openkeyboard-org/OpenController/hardware/CH572/fab/OpenController-CH572-schematic.pdf

1 | 2 | 3 | 4 | 5 | 6

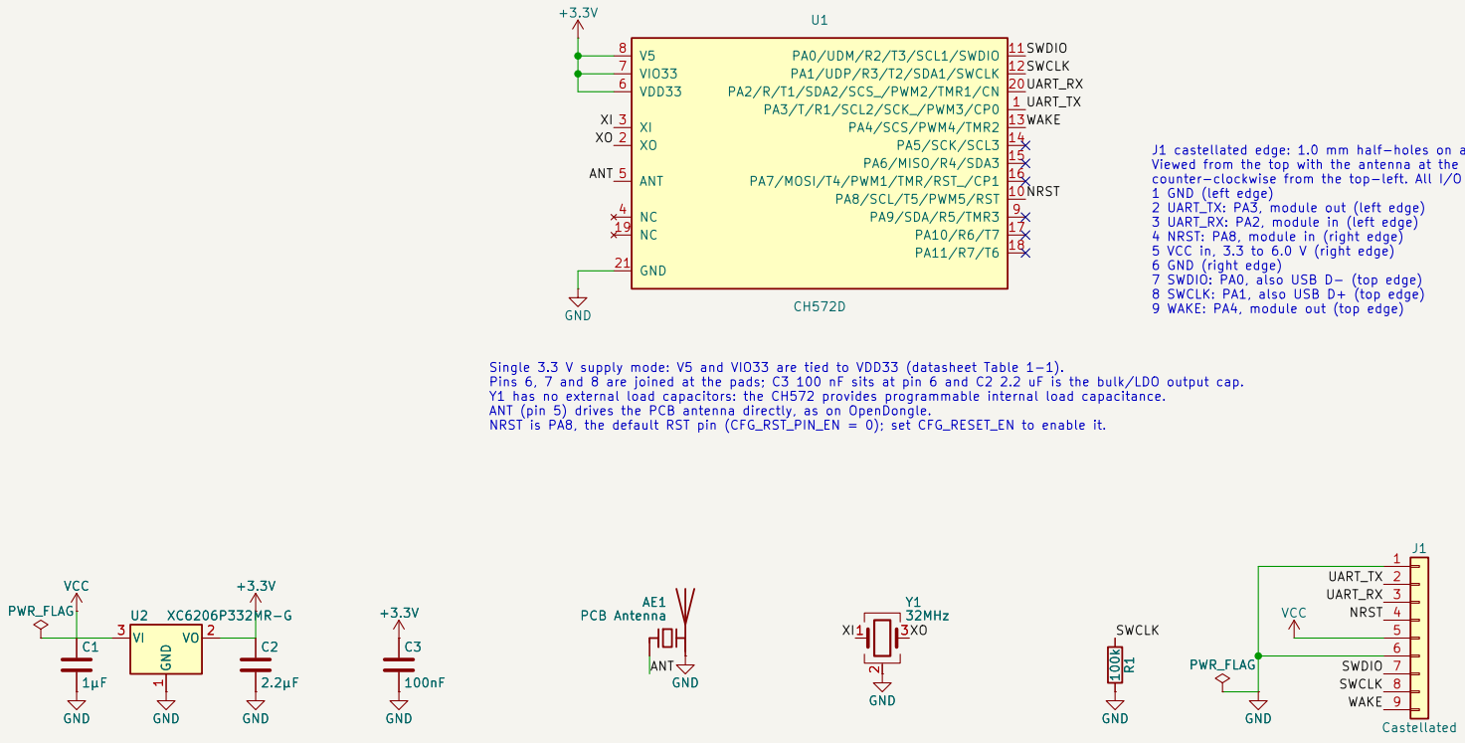
[picture p1: figure]
VCC; AE1 PCB Antenna; GND; Y1 32MHz GND; PWR_FLAG; J1 Castellated PA3/T/R1/SCL2/SCK_/PWM3/CP0; ANT 5; VDD33 6; VIO33 7; PA9/SDA/R5/TMR3; 9 PA8/SCL/T5/PWM5/RST; 10 PA0/UDM/R2/T3/SCL1/SWDIO; 11 PA1/UDP/R3/T2/SDA1/SWCLK; 12 PA4/SCS/PWM4/TMR2; 13 PA5/SCK/SCL3; 14 PA6/MISO/R4/SDA3; 15 PA7/MOSI/T4/PWM1/TMR/RST_/CP1; PA2/R/T1/SDA2/SCS_/PWM2/TMR1/CN; 20 GND 21; GND GND; GND +3.3V C2; +3.3V PWR_FLAG; ANT; WAKE UART_TX; ANT XO; UART_RX; SWDIO; WAKE; SWCLK; Y1 32MHz 1; 3 GND; 100nF GND +3.3V C2; 2.2µF +3.3V GND; GND U2; XC6206P332MR-G GND; VI 3 PWR_FLAG; 1µF GND; GND R1 100k

1 | 2 | 3 | 4 | 5 | 6

AB

C

D

AB

C

### D Date: 2026-10-25

Size: A4 | Rev: 0.1
KiCad E.D.A. 10.0.6 | Id: 1/1

## Title: OpenController CH572

### File: OpenController-CH572.kicad_sch

### Sheet: /

## Copyright 2026 Eric Molitor (EMulator)

### github.com/openkeyboard-org/OpenController

### CERN-OHL-W CERN Open Hardware Licence Version 2 - Weakly Reciprocal C3

NRST | SWCLK UART_RX NRST XI | SWCLK | UART_TX R1 holds PA1 low when J1 pad 8 is left open. PA1 is the ROM boot strap

(PA1 high + PA0 low at power-on enters USB/UART ISP), USB D+ and SWCLK.

J1 castellated edge: 1.0 mm half-holes on a 0.1 in grid, three per edge. Viewed from the top with the antenna at the bottom, pads count counter-clockwise from the top-left. All I/O is 3.3 V. 1 GND (left edge) 2 UART_TX: PA3, module out (left edge) 3 UART_RX: PA2, module in (left edge) 4 NRST: PA8, module in (right edge) 5 VCC in, 3.3 to 6.0 V (right edge) 6 GND (right edge) 7 SWDIO: PA0, also USB D- (top edge) 8 SWCLK: PA1, also USB D+ (top edge) 9 WAKE: PA4, module out (top edge)

Single 3.3 V supply mode: V5 and VIO33 are tied to VDD33 (datasheet Table 1-1). Pins 6, 7 and 8 are joined at the pads; C3 100 nF sits at pin 6 and C2 2.2 uF is the bulk/LDO output cap. Y1 has no external load capacitors: the CH572 provides programmable internal load capacitance. ANT (pin 5) drives the PCB antenna directly, as on OpenDongle. NRST is PA8, the default RST pin (CFG_RST_PIN_EN = 0); set CFG_RESET_EN to enable it. AE1 PCB Antenna | GND
