openkeyboard-org/OpenController/hardware/CH572/OpenController-CH572.kicad_pcb

## KiCad design hardware/CH572/OpenController-CH572.kicad_pcb (2026-10-25)

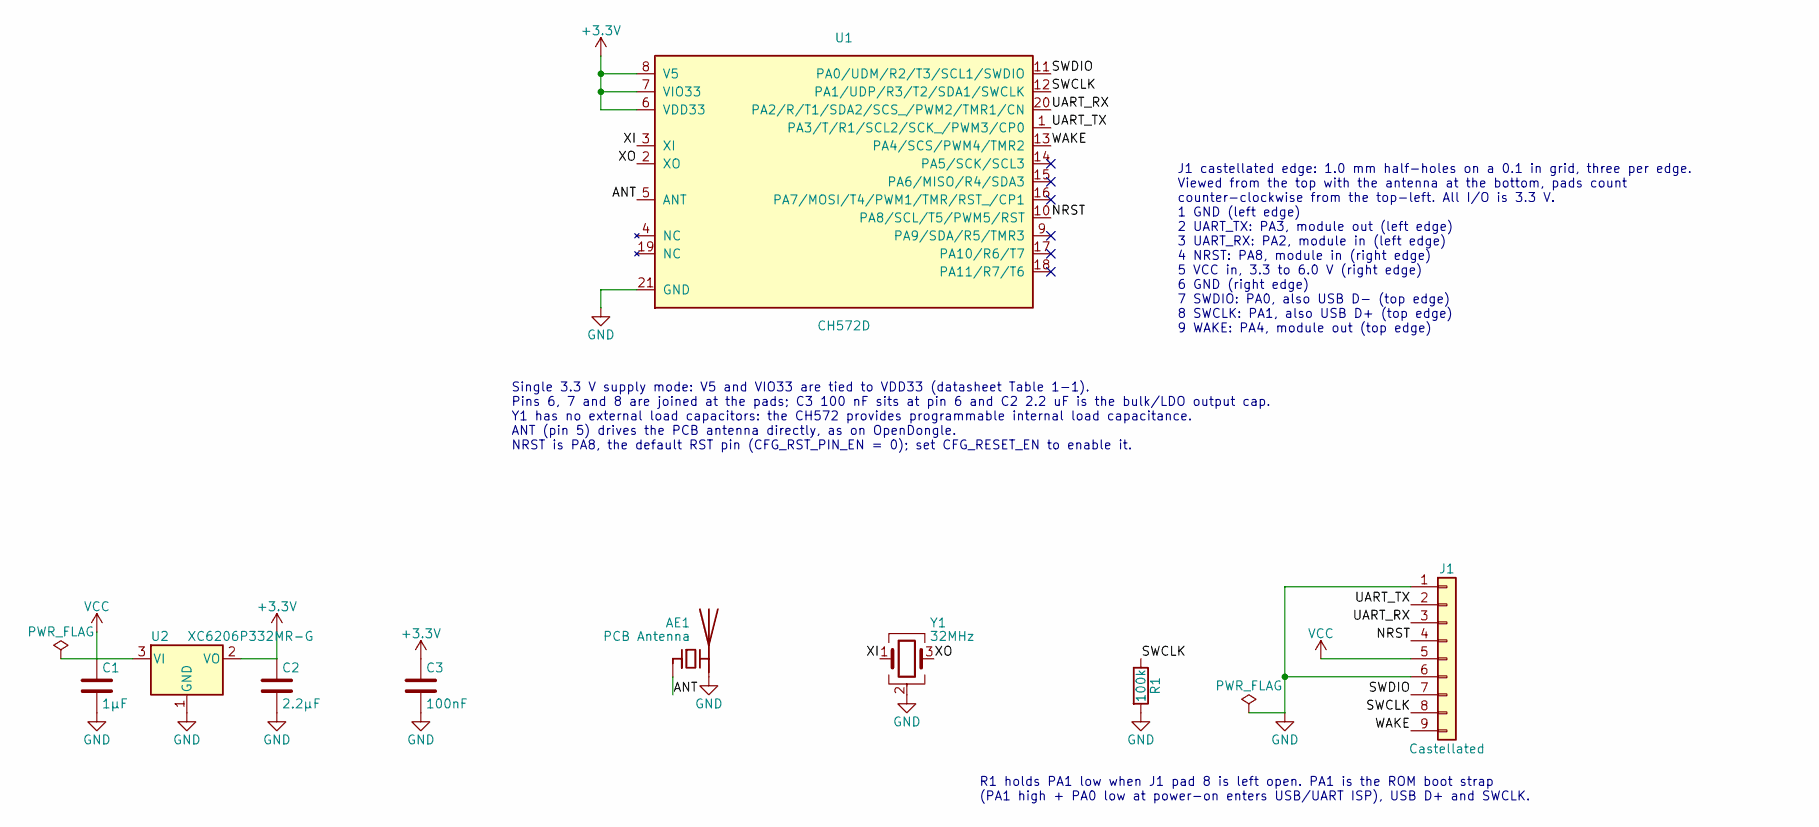
[picture p2: schematic OpenController-CH572.kicad_sch, OpenController CH572]

Parts:
AE1: PCB Antenna; ANT-F-2-2.4G-0.8MM-FR4-WCH
C1: 1µF; C_0603_1608Metric; LCSC C15849
C2: 2.2µF; C_0603_1608Metric; LCSC C23630
C3: 100nF; C_0603_1608Metric; LCSC C14663
J1: Castellated; Castellated_CH572_10.16x20.5mm
R1: 100k; R_0603_1608Metric; LCSC C25803
U1: CH572D; CH572D_QFN-20_3x3mm_P0.4mm_EP1.8mm_ThermalVias; LCSC C46597863
U2: XC6206P332MR-G; SOT-23-3; LCSC C5446
Y1: 32MHz; Crystal_SMD_2016-4Pin_2.0x1.6mm; LCSC C37635332

Connections:
+3.3V: C2.1, C3.1, U1.6 (VDD33), U1.7 (VIO33), U1.8 (V5), U2.2 (VO)
/ANT: AE1.1 (FEED), U1.5 (ANT)
/NRST: J1.4, U1.10 (PA8/SCL/T5/PWM5/RST)
/SWCLK: J1.8, R1.1, U1.12 (PA1/UDP/R3/T2/SDA1/SWCLK)
/SWDIO: J1.7, U1.11 (PA0/UDM/R2/T3/SCL1/SWDIO)
/UART_RX: J1.3, U1.20 (PA2/R/T1/SDA2/SCS_/PWM2/TMR1/CN)
/UART_TX: J1.2, U1.1 (PA3/T/R1/SCL2/SCK_/PWM3/CP0)
/WAKE: J1.9, U1.13 (PA4/SCS/PWM4/TMR2)
/XI: U1.3 (XI), Y1.1
/XO: U1.2 (XO), Y1.3
GND: AE1.2 (PCB_Trace), C1.2, C2.2, C3.2, J1.1, J1.6, R1.2, U1.21 (GND), U2.1 (GND), Y1.2 (G), Y1.4 (G)
VCC: C1.1, J1.5, U2.3 (VI)

Notes on the sheet:
Single 3.3 V supply mode: V5 and VIO33 are tied to VDD33 (datasheet Table 1-1). Pins 6, 7 and 8 are joined at the pads; C3 100 nF sits at pin 6 and C2 2.2 uF is the bulk/LDO output cap. Y1 has no external load capacitors: the CH572 provides programmable internal load capacitance. ANT (pin 5) drives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
R1 holds PA1 low when J1 pad 8 is left open. PA1 is the ROM boot strap (PA1 high + PA0 low at power-on enters USB/UART ISP), USB D+ and SWCLK.
J1 castellated edge: 1.0 mm half-holes on a 0.1 in grid, three per edge. Viewed from the top with the antenna at the bottom, pads count counter-clockwise from the top-left. All I/O is 3.3 V. 1 GND (left edge) 2 UART_TX: PA3, module out (left edge) 3 UART_RX: PA2, module in (left edge) 4 NRST: PA8, 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

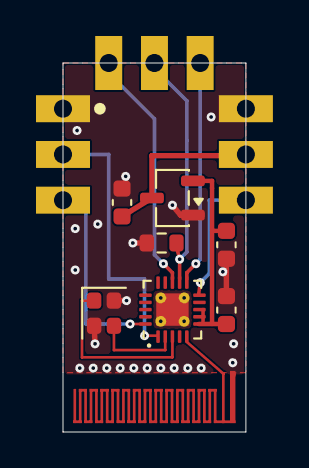
[picture p3: board OpenController-CH572.kicad_pcb from above]

Board: 2 copper layers, 10.2 x 20.5 mm, 9 parts (0 on the bottom side), 12 nets.
