openkeyboard-org/OpenController/firmware/src/rf_task.c

/* Copyright 2026 Eric Molitor (EMulator)
 * SPDX-License-Identifier: Apache-2.0
 */
#include "CONFIG.h"
#include "HAL.h"
#include "ISP592.h"
#include "keyboard_uart.h"
#include "rf_task.h"

#define RF_EVT_START              0x0001
#define RF_EVT_RX_RESTART         0x0002
#define RF_EVT_PAIR_BCAST         0x0004
#define RF_EVT_PAIR_TIMEOUT       0x0008
#define RF_EVT_ENTER_CONNECTED    0x0010
#define RF_EVT_RESPOND            0x0020   /* connected poll-response TX (main loop) */
#define RF_EVT_NOTIFY_LED         0x0040
#define RF_EVT_SAVE_BOND          0x0100   /* deferred DataFlash write, not from RF ISR */
#define RF_EVT_PAIR_RX_OFF        0x0200   /* close the post-beacon listen window
                                            * (bonded-reconnect duty cycle, MR4) */

/* Stock-interop H1/H2 discriminator: skip the first N connected-poll responses
 * (keep listening/tracking, no uplink TX). If the keyboard then catches several
 * MORE stock polls before teardown, the running RX/track is fine and it is our
 * RESPONSE that trips the stock dongle's fast supervision teardown (H1). Needs
 * RF_DIAG_COUNTERS (uses the .diag_safe ll_resp_suppressed counter). */
#ifndef STOCK_SUPPRESS_RESPONSES
#define STOCK_SUPPRESS_RESPONSES 0
#endif
/* H1/H2 probe: after the first caught poll, stay parked on that channel (never
 * advance the time-based hop). If the dongle is still polling, the parked
 * keyboard keeps catching it (=> our hop tracking is the fault); if not, the
 * dongle stopped (=> it tore the link down). */
#ifndef STOCK_PARK_AFTER_CATCH
#define STOCK_PARK_AFTER_CATCH 0
#endif
/* Bench probe: transmit the poll response directly in the TMR0 turnaround ISR
 * instead of deferring to the main-loop RF_EVT_RESPOND event. The direct ISR
 * path did not fix stock reconnect; the validated default is main-loop TX after
 * the 6000-count turnaround below. */
#ifndef STOCK_ISR_FAST_RESPONSE
#define STOCK_ISR_FAST_RESPONSE 0
#endif
/* Fast-response fix (matches stock firmwareB.bin 0x20000f06): skip the redundant
 * RF_SetChannel before the response TX -- the radio is already on the poll channel;
 * re-setting it costs a ~150us PLL relock that misses the stock dongle's RX window. */
#ifndef STOCK_RESP_NO_SETCH
#define STOCK_RESP_NO_SETCH 1
#endif
/* Acquisition coarse-align probe: on the FIRST connected poll
 * caught while parked (provisional), SNAP hop_anchor to that poll's measured
 * start instead of a ±1 servo nudge -- the ±1 servo can't lock a large initial
 * phase error from a single parked catch, so the keyboard misses subsequent
 * polls off the real stock dongle's grid. Keeps the ±1 servo for later polls. */
#ifndef STOCK_ACQ_SNAP
#define STOCK_ACQ_SNAP 0
#endif
/* Gap-free acquisition probe: while provisional, keep the radio continuously
 * parked on the seed/catch channel instead of RF_Shut+RF_Rx re-arming every
 * interval. Pair with STOCK_PARK_AFTER_CATCH=1 to stay parked after the first
 * catch and prove whether periodic re-arm gaps were hiding later stock polls. */
#ifndef STOCK_CONTINUOUS_PARK_ACQ
#define STOCK_CONTINUOUS_PARK_ACQ 0
#endif
/* Bench probe: some stock-dongle reconnect state reports one interval in the
 * LEN-15 payload while its measured connected-poll cadence is another. Nonzero
 * overrides the parsed connected interval after sanity-checking the packet. */
#ifndef STOCK_FORCE_CONN_INTERVAL
#define STOCK_FORCE_CONN_INTERVAL 0
#endif
/* Stock-interop fix: the pair-ACK type tag is the previous connected-hop seed.
 * The dongle's first connected poll one interval later is therefore seed+1.
 * Keep this configurable only for bench regressions against old hypotheses. */
#ifndef STOCK_CONNECT_IDX_BIAS
#define STOCK_CONNECT_IDX_BIAS 1
#endif
#define RF_EVT_DISCONNECT         0x0080
#define RF_EVT_REST_IDLE          0x0400   /* resting policy: no host report for KBD_REST_IDLE_TICKS */
#define RF_EVT_REST_PROBE         0x0800   /* resting policy: probe cadence */
#define RF_EVT_REST_PROBE_TIMEOUT 0x1000   /* resting policy: probe not caught / not polled in time */
#define RF_EVT_REST_STAGE2        0x2000   /* resting policy: stop probing */
#define RF_EVT_DISCARD_HID        0x4000   /* the host left 2.4 GHz: drop what it queued (0x8000 is TMOS's) */

/* A SELECT_USB that a SELECT_2G4 follows within this long is a forced
 * reconnect, not a switch to USB: QMK sends the pair back to back to get a
 * fresh CONNECTED, and the reports queued for 2.4 GHz are still wanted. TMOS
 * ticks of 0.625 ms. */
#ifndef KBD_RESELECT_KEEP_TICKS
#define KBD_RESELECT_KEEP_TICKS   800u     /* 500 ms */
#endif

#define RF_DEFAULT_ACCESS_ADDR    0x71764126u
#define RF_CRC_INIT               0x555555u
#define RF_LLE_MODE               (LLE_MODE_BASIC | LLE_WHITENING_ON | LLE_MODE_PHY_2M)
#define RF_RX_MAX_LEN             70

#define RF_PAIR_INTERVAL          28u
#define RF_PAIR_TIMEOUT_VALUE     600u
#define RF_PAIR_BCAST_TICKS       32u      /* 20 ms at 625 us/tick */
#define RF_PAIR_WINDOW_TICKS      8480u    /* stock pair window is about 5.3 s */
#define RF_PAIR_DWELL_BCASTS      12u

/* Bonded-reconnect radio duty cycle (power ladder MR4). A bonded keyboard
 * whose dongle is absent searches FOREVER (boot-with-bond and A6 30 arm no
 * pair timeout), and until this rung it held the receiver open for the whole
 * 20 ms beacon period -- the single largest measured burner (7.75 mA vs
 * 0.68 mA idle). With the duty cycle, RX stays open only for a short window
 * after each beacon; the dongle's reconnect reply lands right after the
 * beacon it heard, so the window covers it. Behavior change: reconnect
 * latency may grow -- bench-measured before merge, window sized from the
 * distribution. EXPLICIT user pairing (A6 51/63) keeps continuous RX: it is
 * user-attended, latency-sensitive, and bounded by the 5.3 s window.
 *
 * WINDOW LOWER BOUND (bench 2026-09-04, OpenDongle + this module). The
 * OpenDongle CH570 sends its LEN-15 reconnect reply 2.5 ms after the beacon
 * it heard (RF_CH570_PAIR_ACK_PRE_TX_TMOS = 4 x 625 us, the Bridge75 stock
 * keyboard's optimum), ~214 us more to its TX-finish callback (both
 * software-measured on the dongle: accept -> StartTx 2538..2551 us). This
 * receiver arms ~0.2 ms after the beacon (estimate), so a 4-tick (2.5 ms)
 * window closed at beacon + ~2.7 ms -- consistent with that reply completing
 * on the closing edge, not sniffed -- and MISSED IT EVERY TIME from the
 * dongle's terminal camps
 * (its first reconnect after boot, and its channel-8 camp after an EV10
 * give-up): 0 valid RX in 500 beacons, 3/3 dongle cold boots, no recovery
 * short of a fresh pair (whose continuous RX tolerates the late reply). The
 * dongle's EV10 reacquire path replies ~0.3 ms after the beacon, which is
 * why a dongle that had connected once still reconnected -- the window had
 * been sized against that path. 6 ticks = 3.75 ms leaves ~1 ms of
 * packet-completion margin over the camp reply (6/6 cold at 6). Cost:
 * 12.5% -> 18.75% RX duty in bonded search. KNOWN on bench: 4 ticks fails
 * (0/8 cold), 6 ticks works (6/6 cold); 5 and 3 were NOT tested. So <= 4 is
 * proven-bad and < 6 is unproven -- re-measure against a cold-booted dongle
 * before lowering below the 6-tick default. */
#ifndef KBD_PAIR_DUTY_CYCLE
#define KBD_PAIR_DUTY_CYCLE 1
#endif
#ifndef KBD_PAIR_RX_WINDOW_TICKS
#define KBD_PAIR_RX_WINDOW_TICKS 6u        /* 3.75 ms of 20 ms = 18.75% RX duty;
                                            * 4 fails on bench, <6 unproven --
                                            * see the window lower bound above */
#endif

/* Which flavor of PAIRING we are in. Deliberately an EXPLICIT tag set at the
 * three entry points, never inferred from rf_access_addr: fresh pairing
 * flips rf_access_addr to the session AA on its FIRST handshake packet, so
 * the AA cannot distinguish the flavors mid-handshake (adversarial-review
 * finding on the plan). */
#define PAIR_FLAVOR_FRESH   0u             /* A6 51/63: continuous RX */
#define PAIR_FLAVOR_BONDED  1u             /* boot-with-bond / A6 30: duty-cycled */

/* Resting policy (RESTING_POLICY.md). After KBD_REST_IDLE_TICKS without a host
 * report on a connected link, drop the session SILENTLY (no frame to the dongle,
 * which lapses by its own supervision; nothing to the keyboard MCU, which keeps
 * seeing a connected link) and probe the dongle every KBD_REST_PROBE_TICKS with a
 * bonded reconnect that answers KBD_REST_PROBE_ANSWERS polls and goes quiet
 * again. The dongle's detector locks onto that cadence and windows/halts around
 * it. After KBD_REST_STAGE2_TICKS stop probing until a key. A host report while
 * resting probes at once and keeps the session. Ticks are TMOS units (625 us).
 * T_probe / T_deep are production parity (1.010 s / 30 min), owner-decided
 * 2026-09-11. T_idle is 3 s by default, owner-decided 2026-09-13 after the hold
 * sweep (firmware/bench/2026-09-13-rest-hold-sweep: 24 mC per key from rest vs
 * 39 at 5 s, delivery and latency unchanged); the Makefile's KBD_REST_IDLE_MS
 * knob passes it as KBD_REST_IDLE_TICKS (production parity: 5000 ms). */
#ifndef KBD_REST
#define KBD_REST 1
#endif
#ifndef KBD_REST_IDLE_TICKS
#define KBD_REST_IDLE_TICKS          4800u    /* 3 s; the Makefile passes KBD_REST_IDLE_MS x 8/5 */
#endif
#ifndef KBD_REST_PROBE_TICKS
#define KBD_REST_PROBE_TICKS         1616u    /* 1010 ms: inside the dongle's 900-1100 ms cadence window */
#endif
#ifndef KBD_REST_PROBE_ANSWERS
#define KBD_REST_PROBE_ANSWERS       2u       /* polls answered per probe: the dongle's detector needs >= 1;
                                               * 2 keeps a scheduled drop valid even if one answer is lost.
                                               * The average current is answer-count-insensitive (bench:
                                               * the ~50-120 ms burst is the dongle's post-probe supervision
                                               * hold, not our TX) -- see RESTING_POLICY.md. */
#endif
#if KBD_REST && (KBD_REST_PROBE_ANSWERS < 1)
#error "KBD_REST_PROBE_ANSWERS must be >= 1: the dongle's scheduled-drop detector needs at least one answered poll (rf_win_link_rx >= RF_WIN_MIN_LINK_RX), or every probe drop is classified unscheduled and the detector unlocks."
#endif
#ifndef KBD_REST_PROBE_TIMEOUT_TICKS
#define KBD_REST_PROBE_TIMEOUT_TICKS 640u     /* 400 ms: two of the dongle's 200 ms window periods */
#endif
#ifndef KBD_REST_STAGE2_TICKS
#define KBD_REST_STAGE2_TICKS        2880000u /* 30 min: production's second stage */
#endif
#ifndef KBD_REST_IDLE_RETRY_TICKS
#define KBD_REST_IDLE_RETRY_TICKS    160u     /* 100 ms: a report still draining when the idle timer fires */
#endif
#define RF_CONNECTED_TIMEOUT_TICKS 5000u   /* ~3.1 s; FIXED connection supervision --
                                            * the dongle's advertised timeout field is
                                            * intentionally not honored (stock scales it
                                            * by an unproven factor; this is validated) */

#define RF_BOND_EEPROM_OFF        0x4000u  /* DataFlash 0x74000: stock keyboard 2.4G bond page */
#define RF_BOND_EEPROM_ERASE_LEN  256u
#define RF_BOND_MAGIC             0x3244424bu  /* "KBD2" little-endian */
#define RF_BOND_VERSION           1u

#define R32_RTC_CNT_32K_ADDR      0x40001038u
#define SYSTICK_CNT_ADDR          0xE000F008u
#define RTC32K_WRAP               0xa8c00000u   /* RTC32K counter modulus */
#define RF_POLL_BACKDATE_BASE     12u           /* RX latency: a caught poll's start is
                                                 * now-(BASE+(len>>3)) -- LEN 1/3 -> 12,
                                                 * LEN 10/15 -> 13 (the inline servo) */
#define RF_HOP_ANCHOR_BACKDATE    (RF_POLL_BACKDATE_BASE + 1u)  /* seed/re-seed (LEN>=8) */
#define RF_HOP_DESYNC_INTERVALS   64u           /* gap (in intervals) treated as desync */

#ifndef KBD_FACTORY_MAC
#define KBD_FACTORY_MAC 0
#endif

#ifndef KBD_MAC_0
#define KBD_MAC_0 0xbd
#define KBD_MAC_1 0xc3
#define KBD_MAC_2 0xab
#define KBD_MAC_3 0x10
#define KBD_MAC_4 0x53
#define KBD_MAC_5 0x5c
#endif

#ifndef STOCK_SEED_BOND
#define STOCK_SEED_BOND 0
#endif
#ifndef STOCK_SEED_SESSION_AA
#define STOCK_SEED_SESSION_AA 0x00000000u
#endif
#ifndef STOCK_SEED_TYPE_TAG
#define STOCK_SEED_TYPE_TAG 0u
#endif
#ifndef STOCK_SEED_DONGLE_MAC_0
#define STOCK_SEED_DONGLE_MAC_0 0x00
#define STOCK_SEED_DONGLE_MAC_1 0x00
#define STOCK_SEED_DONGLE_MAC_2 0x00
#define STOCK_SEED_DONGLE_MAC_3 0x00
#define STOCK_SEED_DONGLE_MAC_4 0x00
#define STOCK_SEED_DONGLE_MAC_5 0x00
#endif

#if KBD_FACTORY_MAC
/* GetMACAddress writes six bytes through the ROM flash API and requires a
 * four-byte-aligned destination (ISP592.h).  Keep validity separate: an API
 * failure, all-zero value, or erased all-0xFF value must never become a
 * shared RF pairing identity. */
static uint8_t keyboard_mac[6] __attribute__((aligned(4)));
static uint8_t keyboard_mac_valid;
#else
static const uint8_t keyboard_mac[6] = {
    KBD_MAC_0, KBD_MAC_1, KBD_MAC_2, KBD_MAC_3, KBD_MAC_4, KBD_MAC_5
};
#define keyboard_mac_valid 1u
#endif
#define NUM_PAIR_CHANNELS  3u
#define NUM_DATA_CHANNELS  5u
#define RF_HOP_MAX_STEP    NUM_DATA_CHANNELS  /* clamp a stale advance to one full hop cycle */
static const uint8_t pair_channels[NUM_PAIR_CHANNELS] = {8, 17, 26};
static const uint8_t data_channels[NUM_DATA_CHANNELS] = {4, 13, 20, 28, 33};

static uint8_t rf_taskID;
static uint8_t rf_state;
/* PAIR_FLAVOR_* tag; meaningful only while rf_state == RF_STATE_PAIRING. */
static uint8_t pair_flavor;
/* Listen-window epoch: RX_RESTART in PAIRING re-arms the receiver only while
 * this is set. Cleared by the RX_OFF handler so a STALE RX_RESTART (posted by
 * a late TX-finish or RX-error callback before the window closed) cannot
 * silently reopen RX for the rest of the beacon period (adversarial-review
 * finding on the plan). Set by every pairing entry and every beacon. */
static volatile uint8_t pair_rx_open;
/* One close-timer per beacon epoch: set when the first RX_RESTART of the
 * epoch arms the receiver AND starts the RX_OFF timer, so RX-error restarts
 * within the window do not keep extending it. Cleared per beacon and by the
 * RX_OFF handler. */
static volatile uint8_t pair_rx_off_armed;
static int8_t rf_rssi;
static uint32_t rf_access_addr;
static uint8_t rf_channel;
static uint16_t rf_conn_interval;

static uint8_t has_bond;
static uint8_t stored_dongle_mac[6];
static uint32_t stored_session_aa;
static uint8_t stored_type_tag;

typedef struct {
    uint32_t magic;
    uint8_t  version;
    uint8_t  type_tag;
    uint16_t reserved0;
    uint32_t session_aa;
    uint8_t  dongle_mac[6];
    uint16_t reserved1;
    uint32_t checksum;
} rf_bond_record_t;

static uint8_t pair_bcast_count;
static uint8_t pair_payload[10];

static uint8_t pending_type_tag;
static uint16_t pending_interval;
static uint32_t pending_session_aa;

/* Report FIFO (step 3). Replaces the single `hid_report` slot: a report queued
 * while the link is down MUST survive until the dongle actually acknowledges it,
 * otherwise the key-up 60 ms later overwrites the key-down and the first key
 * from rest is lost (measured 35-40 % loss). Stock's module keeps a 20-slot
 * ack-retired ring for exactly this reason.
 * Single-producer / single-consumer: `hid_fifo_tail` is written ONLY by the main
 * loop (RF_QueueHIDReport, from the UART frame callback); `hid_fifo_head` ONLY by
 * the RX ISR when the dongle advances its control bit (the acknowledgement).
 * Free-running indices, power-of-two capacity; occupancy = (uint8_t)(tail-head). */
#define HID_FIFO_SLOTS 16u
#if (HID_FIFO_SLOTS & (HID_FIFO_SLOTS - 1u)) != 0u
#error "HID_FIFO_SLOTS must be a power of two: the head/tail indices are free-running and masked"
#endif
static uint8_t hid_fifo[HID_FIFO_SLOTS][8];
static volatile uint8_t hid_fifo_head;      /* ISR-owned: retire on ack */
static volatile uint8_t hid_fifo_tail;      /* main-loop-owned: enqueue */
static volatile uint8_t hid_head_sent;      /* head is in flight; an ack may retire it */
static uint8_t hid_last_queued[8];          /* newest queued state (adjacent-duplicate dedup) */
static uint8_t hid_last_queued_valid;

/* True while the newest host report holds any key or modifier. */
static inline uint8_t hid_key_held(void)
{
    return (uint8_t)(hid_last_queued_valid
                     && (hid_last_queued[0]|hid_last_queued[1]|hid_last_queued[2]|hid_last_queued[3]
                        |hid_last_queued[4]|hid_last_queued[5]|hid_last_queued[6]|hid_last_queued[7]));
}

/* Drop every queued report. IDLE only: the radio is shut then, so the RX ISR
 * that retires the head can't run. */
static void rf_discard_hid_queue(void)
{
    hid_fifo_head = hid_fifo_tail;
    hid_head_sent = 0;
}
static uint8_t tx_payload[10];
static uint8_t tx_ctrl;
static uint8_t prev_data_idx;     /* current connected data-channel index */
static volatile uint8_t pending_led;
static volatile uint8_t last_led_sent;
/* hid_resend (blind attempt counter) removed: the head is re-sent every poll
 * until acknowledged, and retired ONLY by the ack (see hid_fifo_head). */
static volatile uint8_t hid_tx_down_inflight; /* a non-zero HID frame started TX; awaiting TX_FINISH to count it as on-air */

/* Connected-mode time-based hop (mirrors stock firmwareB.bin 0x20000E06/0x20000D60).
 * hop_anchor (like tx_ctrl) is written by BOTH the RX ISR (hop_servo / ctrl-ARQ) and the
 * main loop, yet is deliberately NOT volatile: every main-loop access is wrapped in
 * rf_irq_save/rf_irq_restore (IRQs off) so the ISR can't interleave a partial update, and
 * the "memory" clobber bars stale caching across the section. */
static uint32_t hop_anchor;             /* RTC32K phase anchor (gp+0x78 equivalent) */
static volatile uint16_t since_rx;      /* hop slots since the last caught poll */
static uint32_t pending_anchor;         /* anchor latched at the 2nd 15-byte (rx-13) */

/* Response-slot latch (Codex): the response must TX on the channel the poll was
 * received on, not the (possibly already-advanced) hop channel, and the hop must
 * not retune the radio while a response is pending. */
static volatile uint8_t  response_channel;
static volatile uint8_t  response_ctrl;
static volatile uint8_t  response_pending;
static volatile uint32_t response_armed_rtc;   /* RTC32K when response_pending was set */
/* Set at (re)connect: PARK on the seed channel (re-arm RX every interval, don't
 * advance the index) until the first poll is caught -- a swept keyboard never
 * meets the swept dongle, so wait for the dongle to sweep onto our parked
 * channel, then the first caught poll snaps the phase and we resume tracking.
 * This is what makes a bonded reconnect lock in (its 15-byte seed mis-aligns
 * the sweep, and with zero catches there is nothing to snap to). */
static volatile uint8_t  provisional;
static volatile uint8_t  bond_save_pending;

/* Set by the RX ISR when a connected-mode poll arrives; the main loop
 * (RF_ConnectedTick) re-arms the supervision timer from it. tmos_start_task /
 * tmos_stop_task mutate the TMOS timer linked list, and our BB status callback is
 * a hardware fast-vectored (VTF) interrupt the lib's TMOS critical section does
 * not mask -- so mutating the list from the ISR would race the main-loop walk
 * (tmos_proces_system_time). We keep list mutation in main-loop context only as a
 * correctness/ISR-safety measure. (NB: the v1.4.2 "TMOS HardFault" this originally
 * chased turned out to be a debugger-perturbation artifact, not an operational
 * fault, but deferring ISR list mutation is good practice regardless and is
 * retained.) */
static volatile uint8_t  supervision_kick;
#if KBD_REST
static uint8_t rest_stage;                    /* 0 not resting, 1 probing, 2 no probes until a key */
static uint8_t rest_probe;                    /* a probe's search/connection is in flight */
static uint8_t rest_probe_wake;               /* a host report arrived: this probe becomes the session */
static uint8_t rest_answers;                  /* polls answered in the current probe */
static volatile uint8_t rest_quiet_pending;   /* end the probe once its reply TX has drained */
#endif


/* TMR0 one-shot post-poll turnaround. Stock firmwareB.bin FUN_ram_00005abe arms
 * 300 TMR0 counts (~5 us @ 60 MHz), but this main-loop deferred TX path needs a
 * longer empirically validated delay for the production stock dongle's RX turn:
 * 6000 counts (~100 us) keeps replies inside the stock post-poll window. */
#ifndef RF_TURNAROUND_COUNT
#define RF_TURNAROUND_COUNT  6000u
#endif

/* SWD-readable diagnostic counters (.diag_safe, NOLOAD -- no flash cost). Gated
 * behind RF_DIAG_COUNTERS (default 1; build a release image with
 * `make RF_DIAG_COUNTERS=0`) so the always-on read-modify-writes -- including in
 * the RX-ISR hot path -- and their SRAM cost vanish when not benching. Use the
 * RF_DIAG_*() macros so a disabled build never drops a wrapped side effect. These are
 * intentionally external symbols (lowercase, despite the file's "lowercase => static"
 * convention) so SWD and the .map can resolve them by name. */
#ifndef RF_DIAG_COUNTERS
#define RF_DIAG_COUNTERS 1
#endif
#if RF_DIAG_COUNTERS
volatile uint32_t rf_cb_count[6] __attribute__((section(".diag_safe")));
volatile uint32_t rf_pair_bcast_count __attribute__((section(".diag_safe")));
volatile uint32_t rf_connected_tx_count __attribute__((section(".diag_safe")));
volatile uint32_t rf_valid_rx_count __attribute__((section(".diag_safe")));
/* .diag_safe.power (NOT the bare section): collected after every legacy
 * counter so bench absolute addresses never move -- see ch592f.ld. */
volatile uint32_t pwr_pair_rx_off_count __attribute__((section(".diag_safe.power")));
#if KBD_REST
/* Resting-policy counters. Plain .bss, NOT .diag_safe: the 0x200 diag window is
 * exactly full, and these are read by symbol from the map, not by absolute
 * address. They do not survive a fault. */
volatile uint32_t rest_entries, rest_probes, rest_probe_catches, rest_probe_misses;
volatile uint32_t rest_key_wakes, rest_stage2_entries;
#endif
/* Report-delivery observability (report-delivery step 1). Plain .bss, read by
 * symbol over SWD post-run (SWD resets the controller and drops the link, so
 * never mid-test): ll_hid_rx counts host reports handed to the RF layer over
 * UART; ll_hid_tx counts LEN-10 HID frames SELECTED for transmission -- it is
 * incremented before RF_Tx(), so a transmission that fails to start still counts,
 * and it must not be read as "reached the air". A key the MCU offered with ll_hid_tx advanced but no host
 * delivery localises the loss downstream of the controller. */
volatile uint32_t ll_hid_rx, ll_hid_tx;
/* Down-only split (non-zero report = a key is pressed): rx_down counts key-downs
 * accepted from the UART, tx_down counts key-downs SELECTED for transmission. */
volatile uint32_t ll_hid_rx_down, ll_hid_tx_down;
/* tx_done_down: a key-down frame that actually COMPLETED on air (TX_FINISH),
 * not merely selected. IMPORTANT: completing on air does NOT mean the dongle
 * received it -- during a reconnect the controller transmits into a link that is
 * not up yet and those frames go nowhere (bench-measured: 108 on-air down-frames,
 * 40 received). These counters bound TRANSMISSION, never delivery; delivery must
 * be read from the dongle's own counters. */
volatile uint32_t ll_hid_tx_done_down;
volatile uint32_t ll_hid_fifo_drop;   /* report dropped: FIFO full (best-effort, as stock) */
volatile uint8_t rf_last_config_status __attribute__((section(".diag_safe")));
volatile uint8_t rf_last_rx_status __attribute__((section(".diag_safe")));
volatile uint8_t rf_last_tx_status __attribute__((section(".diag_safe")));
volatile uint32_t tmr0_irq_count __attribute__((section(".diag_safe")));
/* --- Step-1/hop-hypothesis breadcrumbs (Codex): survive the fault (.diag_safe,
 * NOLOAD) so a watchdog-OFF spin + SRAM snapshot reveals WHERE the fault occurred,
 * not just that it did. entered_connected/connected_tick/hop_advance == 0 at fault
 * exonerates the hand-rolled RTC hop; last_rf_op localizes the RF path in flight;
 * bb_cb_in_cs_count > 0 proves the VTF BB callback fired during a CSR-0x800
 * critical section (i.e. CSR 0x800 does NOT mask the fast-vectored BB -- Step 0). */
volatile uint32_t entered_connected_count __attribute__((section(".diag_safe")));
volatile uint32_t connected_tick_calls    __attribute__((section(".diag_safe")));
volatile uint32_t hop_advance_count       __attribute__((section(".diag_safe")));
volatile uint32_t rf_config_count         __attribute__((section(".diag_safe")));
volatile uint8_t  last_rf_op              __attribute__((section(".diag_safe"))); /* 1=start_rx 2=pair_bcast 3=respond_tx */
volatile uint8_t  last_cb_state          __attribute__((section(".diag_safe"))); /* rf_state at last BB callback */
volatile uint8_t  last_cb_sta            __attribute__((section(".diag_safe"))); /* sta arg at last BB callback */
volatile uint8_t  cb_in_cs               __attribute__((section(".diag_safe"))); /* live: inside a CSR-0x800 CS */
volatile uint32_t bb_cb_in_cs_count       __attribute__((section(".diag_safe"))); /* BB callback fired while cb_in_cs */
/* --- Phase-1 link-lock drop characterization (.diag_safe). Answers: at a drop is
 * the keyboard off-channel / lost lock (ll_dropN_*), does its per-channel catch
 * match the dongle's (ll_kbd_rx_ch), did the runaway/desync or step-clamp fire, and
 * is the servo one-sided (R8: plus/minus/noop). Read post-soak via OpenOCD. */
volatile uint32_t ll_kbd_rx_ch[5] __attribute__((section(".diag_safe")));   /* connected RX caught per data-channel idx */
volatile uint16_t ll_since_rx_max __attribute__((section(".diag_safe")));   /* max since_rx reached */
volatile uint32_t ll_desync_reseed __attribute__((section(".diag_safe")));  /* >64*interval runaway re-seed fired */
volatile uint32_t ll_step_clamp    __attribute__((section(".diag_safe")));  /* step>MAX clamp fired */
volatile uint32_t ll_servo_plus    __attribute__((section(".diag_safe")));  /* servo +1 */
volatile uint32_t ll_servo_minus   __attribute__((section(".diag_safe")));  /* servo -1 */
volatile uint32_t ll_servo_noop    __attribute__((section(".diag_safe")));  /* servo in-sync/deadzone no-op */
volatile uint32_t ll_drop_count    __attribute__((section(".diag_safe")));  /* supervision fired while CONNECTED */
volatile uint32_t ll_drop1_rtc     __attribute__((section(".diag_safe")));  /* RTC32K at first drop */
volatile uint32_t ll_dropN_rtc     __attribute__((section(".diag_safe")));  /* RTC32K at last drop */
volatile uint16_t ll_drop1_since_rx __attribute__((section(".diag_safe")));
volatile uint8_t  ll_drop1_idx      __attribute__((section(".diag_safe")));
volatile uint8_t  ll_drop1_channel  __attribute__((section(".diag_safe")));
volatile uint8_t  ll_drop1_provis   __attribute__((section(".diag_safe")));
volatile uint16_t ll_dropN_since_rx __attribute__((section(".diag_safe")));
volatile uint8_t  ll_dropN_idx      __attribute__((section(".diag_safe")));
volatile uint8_t  ll_dropN_channel  __attribute__((section(".diag_safe")));
volatile uint8_t  ll_dropN_provis   __attribute__((section(".diag_safe")));
/* --- Stock-interop connected-mode trace (.diag_safe): the first LL_TRACE_N RF
 * callbacks after enter_connected. Shows whether the stock dongle keeps polling
 * after our first catch (H1: dongle tears down on an unaccepted response) vs the
 * keyboard mis-phasing and missing every subsequent poll (H2). Per entry:
 * meta = sta | len<<8 | min(since_rx,255)<<16 | flags<<24;
 * flags = idx | connected<<3 | resp_pending<<4 | provisional<<5 | rsr_nz<<6. */
#define LL_TRACE_N 32
volatile uint32_t ll_trace_rtc[LL_TRACE_N]  __attribute__((section(".diag_safe")));
volatile uint32_t ll_trace_meta[LL_TRACE_N] __attribute__((section(".diag_safe")));
volatile uint16_t ll_trace_count __attribute__((section(".diag_safe")));
volatile uint8_t  ll_trace_armed __attribute__((section(".diag_safe")));
volatile uint32_t ll_resp_suppressed __attribute__((section(".diag_safe")));  /* responses skipped by STOCK_SUPPRESS_RESPONSES */
volatile uint32_t ll_boot_count __attribute__((section(".diag_safe")));  /* RF_TaskInit runs = reboots (NOT zeroed by the init block) */
/* --- Connected RX re-arm gap timing (.diag_safe). SysTick runs at Tsys
 * (60 MHz on this build), so these fields measure the RF_Shut/retune/RF_Rx
 * blind spot that RTC32K cannot resolve. */
volatile uint32_t ll_rx_rearm_count __attribute__((section(".diag_safe")));
volatile uint32_t ll_rx_rearm_gap_last __attribute__((section(".diag_safe")));
volatile uint32_t ll_rx_rearm_gap_min __attribute__((section(".diag_safe")));
volatile uint32_t ll_rx_rearm_gap_max __attribute__((section(".diag_safe")));
volatile uint32_t ll_rx_rearm_gap_sum __attribute__((section(".diag_safe")));
volatile uint32_t ll_rx_rearm_begin_sys __attribute__((section(".diag_safe")));
volatile uint32_t ll_rx_rearm_end_sys __attribute__((section(".diag_safe")));
volatile uint32_t ll_rx_cb_last_sys __attribute__((section(".diag_safe")));
volatile uint32_t ll_rx_since_rearm_sys __attribute__((section(".diag_safe")));
volatile uint8_t  ll_rx_rearm_last_idx __attribute__((section(".diag_safe")));
volatile uint8_t  ll_rx_rearm_last_channel __attribute__((section(".diag_safe")));
volatile uint8_t  ll_rx_rearm_last_provis __attribute__((section(".diag_safe")));
#define RF_DIAG_INC(x)    ((x)++)
#define RF_DIAG_SET(x, v) ((x) = (v))
#else
#define RF_DIAG_INC(x)    ((void)0)
#define RF_DIAG_SET(x, v) ((void)(v))
#endif

static uint16_t RF_ProcessEvent(uint8_t task_id, uint16_t events);
static uint8_t rf_configure(uint32_t access_addr);
static void rf_start_rx(uint8_t channel);
static void rf_pair_broadcast(void);
static void rf_enter_connected(void);
static void rf_do_response_tx(void);
static void rf_tmr0_stop(void);
#if KBD_REST
static void rest_cancel(void);
static void rest_arm_idle(void);
static void rest_enter(void);
static void rest_probe_start(void);
static void rest_probe_end(uint8_t caught);
static void rest_promote_to_normal(void);
#endif
static void rf_tmr0_arm(uint32_t count);

static uint32_t read_be32(const uint8_t *p)
{
    return ((uint32_t)p[0] << 24) |
           ((uint32_t)p[1] << 16) |
           ((uint32_t)p[2] << 8) |
           (uint32_t)p[3];
}

static uint8_t mac_equal(const uint8_t *a, const uint8_t *b)
{
    for (uint8_t i = 0; i < 6; i++) {
        if (a[i] != b[i]) {
            return 0;
        }
    }
    return 1;
}

static void rf_init_keyboard_identity(void)
{
#if KBD_FACTORY_MAC
    uint8_t all_zero = 1;
    uint8_t all_ff = 1;

    keyboard_mac_valid = 0;
    for (uint8_t i = 0; i < sizeof(keyboard_mac); i++) {
        keyboard_mac[i] = 0;
    }
    if (GetMACAddress(keyboard_mac) != 0) {
        return;
    }
    for (uint8_t i = 0; i < sizeof(keyboard_mac); i++) {
        if (keyboard_mac[i] != 0x00) {
            all_zero = 0;
        }
        if (keyboard_mac[i] != 0xFF) {
            all_ff = 0;
        }
    }
    keyboard_mac_valid = (uint8_t)(!all_zero && !all_ff);
#endif
}

static uint32_t rtc_read_32k(void)
{
    return *(volatile uint32_t *)R32_RTC_CNT_32K_ADDR;
}

#if RF_DIAG_COUNTERS
static uint32_t systick_read(void)
{
    return *(volatile uint32_t *)SYSTICK_CNT_ADDR;
}
#endif

/* The CH59x RTC32K reader can return a sample a few ticks BEHIND the previous
 * one (a known non-monotonic quirk -- the dongle uses the same 1024-tick
 * tolerance). Without this, one bad backward sample while hop_anchor is normally
 * only a few ticks behind `now` makes rtc_delta_32k() return ~RTC32K_WRAP, which
 * clamps step=5 and sends the hop into a same-channel runaway (the measured
 * cliff). Treat a small backstep as ZERO elapsed; only a near-modulus span is a
 * true 24h wrap. */
#define RTC32K_BACKSTEP_TOLERANCE  1024u

static uint32_t rtc_delta_32k(uint32_t now, uint32_t then)
{
    if (now >= then) {
        return now - then;
    }
    if ((then - now) <= RTC32K_BACKSTEP_TOLERANCE) {
        return 0u;   /* RTC32K backstep, not a wrap */
    }
    return RTC32K_WRAP - then + now;
}

static uint32_t rtc_backdate_32k(uint32_t t, uint32_t ticks)
{
    return (t >= ticks) ? (t - ticks) : (RTC32K_WRAP - (ticks - t));
}

static uint32_t rtc_add_32k(uint32_t t, uint32_t ticks)
{
    uint32_t s = t + ticks;
    while (s >= RTC32K_WRAP) {
        s -= RTC32K_WRAP;
    }
    return s;
}

/* SIGNED shortest-path phase delta (ref - a) around the RTC32K modulus, result in
 * (-WRAP/2, +WRAP/2]. Unlike rtc_delta_32k() this does NOT apply the 1024-tick
 * backstep tolerance -- the PLL servo needs the SIGN of a small negative error to
 * apply -1. (rtc_delta_32k collapses "anchor a few ticks ahead of ref" to 0, which
 * made the servo +1-only and let phase bias accumulate until the hop slipped
 * off-channel -- the connected-mode drop root cause, R8.) Servo-only: a spurious
 * RTC32K backstep costs at most one bounded -1 tick here (self-corrected next poll)
 * and cannot reach the elapsed-scheduling path, so the wrap/clamp cliff that the
 * 1024 tolerance protects rtc_delta_32k() from is not reintroduced. */
static int32_t rtc_signed_delta_32k(uint32_t ref, uint32_t a)
{
    uint32_t fwd = (ref >= a) ? (ref - a) : (RTC32K_WRAP - a + ref);  /* a -> ref, [0,WRAP) */
    if (fwd <= (RTC32K_WRAP >> 1)) {
        return (int32_t)fwd;                       /* ref at/ahead of anchor (>=0) */
    }
    return -(int32_t)(RTC32K_WRAP - fwd);          /* ref behind anchor (<0) */
}

/* QingKe global-interrupt save/restore (CSR 0x800 INTSYSCR, bits MPIE|MIE=0x88),
 * matching the CH592 EVT __risc_v_disable_irq/enable_irq. Used to make the
 * connected-hop anchor update atomic against the RX-ISR servo -- stock runs its
 * hop scheduler (0x20000E06) under the same IRQ save/restore. */
__attribute__((always_inline)) static inline uint32_t rf_irq_save(void)
{
    uint32_t r;
    __asm volatile ("csrrc %0, 0x800, %1" : "=r"(r) : "r"(0x88) : "memory");
#if RF_DIAG_COUNTERS
    cb_in_cs = 1;   /* IRQs now masked; BB callback flags a hit if it fires anyway */
#endif
    return r & 0x88;
}
__attribute__((always_inline)) static inline void rf_irq_restore(uint32_t s)
{
#if RF_DIAG_COUNTERS
    cb_in_cs = 0;   /* clear BEFORE re-enabling: no enabled-but-flagged window */
#endif
    uint32_t t;
    __asm volatile ("csrrs %0, 0x800, %1" : "=r"(t) : "r"(s) : "memory");
}

/* Wrap the app's TMOS timer-list mutators in a global-IRQ critical section as a
 * defensive measure. The v1.4.2 BLE lib guards its own TMOS list ops by masking
 * only BLEL (IRQ 21); our BB status callback is a fast-vectored (VTF) BLEB (IRQ 20)
 * interrupt v1.4.2 does not mask, so in principle a BB interrupt landing mid
 * app-list-mutation could race the main-loop walk (tmos_proces_system_time).
 * Disabling interrupts globally around each app list mutation closes that window.
 * (NB: the v1.4.2 "TMOS HardFault" this was aimed at proved to be a
 * debugger-perturbation artifact rather than an operational fault, and
 * `bb_cb_in_cs_count` measured 0 BB-in-CS hits in a soak; the wrap is cheap
 * defense-in-depth and is retained. v1.00's spinlock did not need
 * it; harmless there.) */
static void rf_start_task_atomic(uint16_t evt, uint32_t ticks)
{
    uint32_t irq = rf_irq_save();
    tmos_start_task(rf_taskID, evt, ticks);
    rf_irq_restore(irq);
}
static void rf_stop_task_atomic(uint16_t evt)
{
    uint32_t irq = rf_irq_save();
    tmos_stop_task(rf_taskID, evt);
    rf_irq_restore(irq);
}
/* tmos_set_event() is also a non-atomic event-halfword RMW in v1.4.2, so post
 * RF task events under the same global mask from both ISR and main-loop paths. */
static void rf_set_event_atomic(uint16_t evt)
{
    uint32_t irq = rf_irq_save();
    tmos_set_event(rf_taskID, evt);
    rf_irq_restore(irq);
}

static uint32_t rf_bond_checksum(const rf_bond_record_t *rec)
{
    const uint8_t *p = (const uint8_t *)rec;
    uint32_t sum = 0;
    uint8_t len = (uint8_t)(sizeof(*rec) - sizeof(rec->checksum));

    for (uint8_t i = 0; i < len; i++) {
        sum += p[i];
    }
    return sum;
}

static uint8_t rf_bond_record_valid(const rf_bond_record_t *rec)
{
    if (rec->magic != RF_BOND_MAGIC || rec->version != RF_BOND_VERSION) {
        return 0;
    }
    if (rec->checksum != rf_bond_checksum(rec)) {
        return 0;
    }
    if (rec->session_aa == 0u || rec->session_aa == RF_DEFAULT_ACCESS_ADDR) {
        return 0;
    }
    return 1;
}

static void rf_build_bond_record(rf_bond_record_t *rec)
{
    tmos_memset(rec, 0, sizeof(*rec));
    rec->magic = RF_BOND_MAGIC;
    rec->version = RF_BOND_VERSION;
    rec->type_tag = stored_type_tag;
    rec->session_aa = stored_session_aa;
    for (uint8_t i = 0; i < 6; i++) {
        rec->dongle_mac[i] = stored_dongle_mac[i];
    }
    rec->checksum = rf_bond_checksum(rec);
}

static uint8_t rf_bond_record_matches(const rf_bond_record_t *a,
                                      const rf_bond_record_t *b)
{
    const uint8_t *pa = (const uint8_t *)a;
    const uint8_t *pb = (const uint8_t *)b;

    for (uint8_t i = 0; i < sizeof(*a); i++) {
        if (pa[i] != pb[i]) {
            return 0;
        }
    }
    return 1;
}

static uint8_t rf_bond_flash_is_erased(const rf_bond_record_t *rec)
{
    const uint8_t *p = (const uint8_t *)rec;

    for (uint8_t i = 0; i < sizeof(*rec); i++) {
        if (p[i] != 0xffu) {
            return 0;
        }
    }
    return 1;
}

static uint8_t rf_load_bond_from_flash(void)
{
    rf_bond_record_t rec __attribute__((aligned(4)));

    if (EEPROM_READ(RF_BOND_EEPROM_OFF, &rec, sizeof(rec)) != 0) {
        return 0;
    }
    if (!rf_bond_record_valid(&rec)) {
        return 0;
    }

    stored_session_aa = rec.session_aa;
    stored_type_tag = rec.type_tag;
    for (uint8_t i = 0; i < 6; i++) {
        stored_dongle_mac[i] = rec.dongle_mac[i];
    }
    has_bond = 1;
    return 1;
}

static void rf_save_bond_to_flash(void)
{
    rf_bond_record_t want __attribute__((aligned(4)));
    rf_bond_record_t cur __attribute__((aligned(4)));
    uint8_t have_cur = 0;

    if (!has_bond) {
        return;
    }

    rf_build_bond_record(&want);
    if (EEPROM_READ(RF_BOND_EEPROM_OFF, &cur, sizeof(cur)) == 0) {
        have_cur = 1;
        if (rf_bond_record_valid(&cur) && rf_bond_record_matches(&cur, &want)) {
            return;
        }
    }

    if (!have_cur || !rf_bond_flash_is_erased(&cur)) {
        if (EEPROM_ERASE(RF_BOND_EEPROM_OFF, RF_BOND_EEPROM_ERASE_LEN) != 0) {
            return;
        }
    }
    (void)EEPROM_WRITE(RF_BOND_EEPROM_OFF, &want, sizeof(want));
}

static void rf_clear_bond_ram(void)
{
    has_bond = 0;
    stored_session_aa = 0;
    stored_type_tag = 0;
    tmos_memset(stored_dongle_mac, 0, sizeof(stored_dongle_mac));
}

static void rf_clear_bond_flash(void)
{
    (void)EEPROM_ERASE(RF_BOND_EEPROM_OFF, RF_BOND_EEPROM_ERASE_LEN);
}

/* PLL servo (stock 0x20000D60): pull the hop anchor toward the reference time
 * (the poll's start, now-(12+(len>>3))) by EXACTLY +/-1 RTC32K tick, shortest
 * direction around the wrap. Pure +/-1 like stock -- no snap. (A snap to the ref
 * over-corrects on RX-callback jitter and can slip the data-channel index.)
 *
 * Uses the SIGNED comparator rtc_signed_delta_32k(): the previous version routed
 * through rtc_delta_32k() whose 1024-tick backstep tolerance collapsed the small
 * "anchor ahead of ref" case to 0, making the servo +1-ONLY (-1 was unreachable).
 * That one-sided servo let phase bias accumulate until the timed hop slipped off
 * the dongle's poll channel -> lock loss -> the connected-mode drops (R8, bench
 * proven RF-independent). A tiny symmetric deadband suppresses +/-1 chatter on
 * sub-tick jitter; real errors get corrected in BOTH directions. */
/* LINK_LOCK_SERVO_FIX gates the R8 fix so the ABAB bench crossover can build the old
 * (+1-only) and new (bipolar) servo from one tree (`make LINK_LOCK_SERVO_FIX=0` = old). */
#ifndef LINK_LOCK_SERVO_FIX
#define LINK_LOCK_SERVO_FIX 1
#endif
#define SERVO_DEADBAND  1   /* |phase err| <= this many RTC32K ticks -> no correction */
__HIGH_CODE
static void hop_servo(uint32_t ref)
{
#if LINK_LOCK_SERVO_FIX
    int32_t err = rtc_signed_delta_32k(ref, hop_anchor);   /* ref - anchor, signed */

    if (err > SERVO_DEADBAND) {
        RF_DIAG_INC(ll_servo_plus);
        hop_anchor = rtc_add_32k(hop_anchor, 1);            /* ref ahead: +1 */
    } else if (err < -SERVO_DEADBAND) {
        RF_DIAG_INC(ll_servo_minus);
        hop_anchor = rtc_backdate_32k(hop_anchor, 1);       /* ref behind: -1 (mod wrap) */
    } else {
        RF_DIAG_INC(ll_servo_noop);                         /* within deadband: in sync */
    }
#else
    /* Original R8 servo (+1-only in practice: rtc_delta_32k swallows small -err). */
    uint32_t a = hop_anchor;
    uint32_t fwd = rtc_delta_32k(ref, a);
    uint32_t bwd = RTC32K_WRAP - fwd;
    if (fwd == 0) { RF_DIAG_INC(ll_servo_noop); return; }
    if (fwd <= bwd) { RF_DIAG_INC(ll_servo_plus);  hop_anchor = rtc_add_32k(a, 1); }
    else            { RF_DIAG_INC(ll_servo_minus); hop_anchor = rtc_backdate_32k(a, 1); }
#endif
}

#if RF_DIAG_COUNTERS
/* Record one RF callback into the connected-mode trace ring (armed at
 * rf_enter_connected, self-stops after LL_TRACE_N entries). */
__HIGH_CODE
static void ll_trace_rec(uint8_t sta, uint8_t rsr, const uint8_t *rxBuf)
{
    uint16_t n, sr;
    uint8_t len, flags, trace_since;
    if (!ll_trace_armed) return;
    n = ll_trace_count;
    if (n >= LL_TRACE_N) { ll_trace_armed = 0; return; }
    len = (uint8_t)((sta == RX_MODE_RX_DATA && rxBuf != 0) ? rxBuf[1] : 0u);
    flags = (uint8_t)(prev_data_idx & 0x07u)
          | (uint8_t)((rf_state == RF_STATE_CONNECTED) ? 0x08u : 0u)
          | (uint8_t)((response_pending != 0) ? 0x10u : 0u)
          | (uint8_t)((provisional != 0) ? 0x20u : 0u)
          | (uint8_t)((sta == RX_MODE_RX_DATA && rsr != 0) ? 0x40u : 0u);
    ll_trace_rtc[n] = rtc_read_32k();
    sr = since_rx;
    trace_since = (uint8_t)((sr > 0xffu) ? 0xffu : sr);
    ll_trace_meta[n] = (uint32_t)sta | ((uint32_t)len << 8)
                     | ((uint32_t)trace_since << 16) | ((uint32_t)flags << 24);
    ll_trace_count = (uint16_t)(n + 1u);
}

__HIGH_CODE
static void ll_record_rx_rearm_gap(uint32_t begin_sys, uint32_t end_sys)
{
    uint32_t gap = end_sys - begin_sys;

    ll_rx_rearm_count++;
    ll_rx_rearm_gap_last = gap;
    if (ll_rx_rearm_gap_min == 0u || gap < ll_rx_rearm_gap_min) {
        ll_rx_rearm_gap_min = gap;
    }
    if (gap > ll_rx_rearm_gap_max) {
        ll_rx_rearm_gap_max = gap;
    }
    ll_rx_rearm_gap_sum += gap;
    ll_rx_rearm_begin_sys = begin_sys;
    ll_rx_rearm_end_sys = end_sys;
    ll_rx_rearm_last_idx = prev_data_idx;
    ll_rx_rearm_last_channel = rf_channel;
    ll_rx_rearm_last_provis = provisional;
}
#endif

__HIGH_CODE
void RF_2G4StatusCallBack(uint8_t sta, uint8_t rsr, uint8_t *rxBuf)
{
    RF_DIAG_INC(rf_cb_count[0]);
#if RF_DIAG_COUNTERS
    ll_trace_rec(sta, rsr, rxBuf);
#endif
#if RF_DIAG_COUNTERS
    last_cb_sta = sta;
    last_cb_state = rf_state;
    if (cb_in_cs) {
        bb_cb_in_cs_count++;   /* VTF BB fired during a CSR-0x800 CS -> mask leak */
    }
#endif

    if (sta == RX_MODE_RX_DATA) {
        RF_DIAG_INC(rf_cb_count[(rsr == 0) ? 1 : 2]);
        if (rsr != 0 || rxBuf == 0) {
            rf_set_event_atomic(RF_EVT_RX_RESTART);
            return;
        }

        RF_DIAG_INC(rf_valid_rx_count);
        rf_rssi = (int8_t)rxBuf[0];

        if (rf_state == RF_STATE_PAIRING && rxBuf[1] == 15 && rxBuf[6] < 5) {
            const uint8_t *payload = &rxBuf[2];
            uint32_t session_aa = read_be32(payload);
            uint16_t interval = (uint16_t)payload[5] |
                                ((uint16_t)payload[6] << 8);
            const uint8_t *dongle_mac = &payload[9];

            if (!has_bond) {
                for (uint8_t i = 0; i < 6; i++) {
                    stored_dongle_mac[i] = dongle_mac[i];
                }
                stored_session_aa = session_aa;
                stored_type_tag = payload[4];
                has_bond = 1;
                rf_access_addr = stored_session_aa;
                rf_set_event_atomic(RF_EVT_RX_RESTART);
                return;
            }

            if (mac_equal(stored_dongle_mac, dongle_mac)) {
                uint16_t eff_interval = interval ? interval : RF_PAIR_INTERVAL;
                /* Reject (don't clamp) a pathological advertised poll interval:
                 * clamping to a value != the dongle's real interval would
                 * silently desync the hop schedule. [20,40] brackets the
                 * validated 28. These units are RTC32K hop slots, not TMOS
                 * supervision ticks, so the bound is a protocol sanity check rather
                 * than a since_rx wrap guard. */
                if (eff_interval < 20u || eff_interval > 40u) {
                    rf_set_event_atomic(RF_EVT_RX_RESTART);
                    return;
                }
#if STOCK_FORCE_CONN_INTERVAL
                eff_interval = STOCK_FORCE_CONN_INTERVAL;
#endif
                pending_session_aa = session_aa;
                pending_type_tag = payload[4];
                pending_interval = eff_interval;
                /* Seed the hop anchor at this 2nd 15-byte's start (now-13),
                 * matching stock (PROTOCOL.md): the connected time-based hop and
                 * the PLL servo both reference this anchor. */
                pending_anchor = rtc_backdate_32k(rtc_read_32k(),
                                                  RF_HOP_ANCHOR_BACKDATE);
                rf_set_event_atomic(RF_EVT_ENTER_CONNECTED);
                return;
            }
        }

        if (rf_state == RF_STATE_CONNECTED) {
            uint8_t len = rxBuf[1];

            /* Genuine connected polls are LEN 1 (poll), 3 (LED relay) or 10 (HID).
             * Any other length (incl. the dongle's LEN-15 re-key/pair bursts) is
             * ignored here -- responding to them disrupts the lock. (Measured: the
             * keyboard never even receives the EV10 LEN-15 re-key before a drop --
             * the drop is loss of channel lock, not an EV10-rekey-ignore.) */
            if (len != 1u && len != 3u && len != 10u) {
                rf_set_event_atomic(RF_EVT_RX_RESTART);
                return;
            }
#if RF_DIAG_COUNTERS
            {
                uint32_t cb_sys = systick_read();
                ll_rx_cb_last_sys = cb_sys;
                ll_rx_since_rearm_sys = cb_sys - ll_rx_rearm_end_sys;
            }
#endif
            uint8_t rx_ctrl = rxBuf[2];   /* read only after the length is validated */

            /* PLL servo (stock 0x20001192 -> 0x20000D60): nudge the hop anchor
             * toward this poll's start time INLINE in the RX ISR, exactly like
             * stock. RF_ConnectedTick's anchor update runs in a critical section
             * so this ISR write can't corrupt it. Stock backdates by 12+(len>>3):
             * LEN 1/3 polls use 12, LEN 10/15 use 13. */
            {
                uint32_t poll_ref = rtc_backdate_32k(rtc_read_32k(),
                                                     RF_POLL_BACKDATE_BASE + (len >> 3));
#if STOCK_ACQ_SNAP
                if (provisional) {
                    hop_anchor = poll_ref;   /* acquisition: coarse-snap the hop grid to this poll */
                } else {
                    hop_servo(poll_ref);     /* steady state: ±1 servo */
                }
#else
                hop_servo(poll_ref);
#endif
            }
#if RF_DIAG_COUNTERS
            if (prev_data_idx < NUM_DATA_CHANNELS) ll_kbd_rx_ch[prev_data_idx]++;
#endif
            since_rx = 0;
#if !STOCK_PARK_AFTER_CATCH
            provisional = 0;   /* locked: caught a poll, resume tracking */
#endif
            if (bond_save_pending) {
                bond_save_pending = 0;
                rf_set_event_atomic(RF_EVT_SAVE_BOND);
            }
            /* STOCK_PARK_AFTER_CATCH: stay parked on the catch channel (never
             * advance the hop) -- H1/H2 probe: if the dongle keeps polling it
             * sweeps back here every 5 intervals and we keep catching. */

            if ((rx_ctrl ^ tx_ctrl) & 0x01) {
                tx_ctrl = (uint8_t)(((tx_ctrl & (uint8_t)~0x01) |
                                     (rx_ctrl & 0x01)) ^ 0x02);
                /* The dongle advanced its control bit: it accepted the frame we
                 * had in flight. That ack -- and ONLY that ack -- retires the
                 * head, so a report queued while the link was down is never
                 * discarded by a blind attempt counter. hid_head_sent guards the
                 * advance that arrives before we have ever sent this head. */
                if (hid_head_sent) {
                    hid_head_sent = 0;
                    if (hid_fifo_tail != hid_fifo_head) {
                        hid_fifo_head++;
                    }
                }
            }

            /* Always keep the newest relay: comparing a new one with the last
             * byte SENT instead would drop a change back to that byte while an
             * earlier change still waits for the handler, which would then
             * send the earlier, stale byte. The handler skips a byte the host
             * already has. */
            if (len == 3 && rxBuf[3] == 0xA1) {
                pending_led = rxBuf[4];
                if (pending_led != last_led_sent) {
                    rf_set_event_atomic(RF_EVT_NOTIFY_LED);
                }
            }

            /* Re-arm the supervision timer in the main loop (RF_ConnectedTick),
             * NOT here: tmos_start/stop_task are not safe from this ISR (see the
             * supervision_kick note above). */
            supervision_kick = 1;

            /* Latch the response channel + ctrl NOW: the response must go
             * out on the channel THIS poll arrived on, and RF_ConnectedTick must
             * not retune/shut the radio while it is pending. Then arm the TMR0
             * one-shot turnaround; its IRQ posts RF_EVT_RESPOND and the main-loop
             * handler TXes on the latched channel, landing the response in the
             * dongle's post-poll RX window. */
            response_channel = rf_channel;
            response_ctrl = tx_ctrl;
            response_armed_rtc = rtc_read_32k();
            response_pending = 1;
            rf_tmr0_arm(RF_TURNAROUND_COUNT);
            return;
        }

        rf_set_event_atomic(RF_EVT_RX_RESTART);
        return;
    }

    if (sta == TX_MODE_TX_FINISH) {
        RF_DIAG_INC(rf_cb_count[3]);
        if (hid_tx_down_inflight && response_pending) {
            /* response_pending still set == this TX_FINISH is THIS connected response
             * (the handler clears it just below), not a keepalive/pairing-beacon
             * finish inheriting a flag left stale by an abandoned TX (codex). */
            RF_DIAG_INC(ll_hid_tx_done_down);   /* a key-down frame COMPLETED on air */
        }
        hid_tx_down_inflight = 0;
#if KBD_REST
        /* Count a probe answer only once the response actually COMPLETED. RF_Tx()
         * returning 0 merely starts the transmission, and a started TX can still
         * reach TX_MODE_TX_FAIL -- counting at start could end the probe having
         * delivered nothing, which is exactly what makes the dongle classify the
         * drop as unscheduled (rf_win_link_rx == 0) and unlock its detector.
         * response_pending distinguishes a connected response from a pairing
         * beacon, which raises TX_FINISH too; it is cleared just below. */
        if (response_pending && rest_probe && !rest_probe_wake) {
            if (++rest_answers >= KBD_REST_PROBE_ANSWERS) {
                rest_quiet_pending = 1;   /* RF_ConnectedTick ends the probe */
            }
        }
#endif
        response_pending = 0;   /* response done -> hop may retune again */
        rf_set_event_atomic(RF_EVT_RX_RESTART);
        return;
    }

    if (sta == TX_MODE_TX_FAIL) {
        RF_DIAG_INC(rf_cb_count[4]);
        hid_tx_down_inflight = 0;   /* started but did not complete: not on air */
        response_pending = 0;
        rf_set_event_atomic(RF_EVT_RX_RESTART);
        return;
    }

    RF_DIAG_INC(rf_cb_count[5]);
    rf_set_event_atomic(RF_EVT_RX_RESTART);
}

/* Build + transmit the poll response on the latched channel: LEN=10 HID while a
 * changed report is pending (a few resends), else a LEN=1 [ctrl] keepalive. TX
 * skips the full RF_Config (AA/mode still set from the last rf_start_rx) to cut
 * turnaround latency; TX_FINISH clears response_pending and re-arms RX. Called
 * from the main-loop RF_EVT_RESPOND handler, OR (STOCK_ISR_FAST_RESPONSE) directly
 * from the TMR0 turnaround ISR. __HIGH_CODE + register-level RF ops keep it ISR-safe. */
__HIGH_CODE
static void rf_do_response_tx(void)
{
    uint8_t tx_len;
    uint8_t sel_down = 0;   /* this frame carries a key-down (non-zero report) */

    if (!response_pending) {
        return;
    }
    hid_tx_down_inflight = 0;   /* start clean: set below only if THIS TX is a started down */

#if STOCK_SUPPRESS_RESPONSES
    if (ll_resp_suppressed < (uint32_t)STOCK_SUPPRESS_RESPONSES) {
        ll_resp_suppressed++;
        response_pending = 0;
        rf_set_event_atomic(RF_EVT_RX_RESTART);
        return;
    }
#endif
    tx_payload[0] = response_ctrl;
    {
        /* Select the head atomically against the RX-ISR retire: the occupancy
         * test and the slot index must observe ONE head, or a retire landing
         * between them would make us transmit an already-acknowledged (older)
         * state as if it were new (codex). */
        uint32_t irq = rf_irq_save();
        uint8_t  h   = hid_fifo_head;
        if ((uint8_t)(hid_fifo_tail - h) != 0u) {
            const uint8_t *head = hid_fifo[h & (HID_FIFO_SLOTS - 1u)];
            tx_payload[1] = 0xA1;
            for (uint8_t i = 0; i < 8; i++) {
                tx_payload[2 + i] = head[i];
            }
            tx_len = 10;
            if (head[0]|head[1]|head[2]|head[3]|head[4]|head[5]|head[6]|head[7]) {
                sel_down = 1;
            }
        } else {
            tx_len = 1;
        }
        rf_irq_restore(irq);
    }
    if (tx_len == 10) {
        RF_DIAG_INC(ll_hid_tx);
        if (sel_down) { RF_DIAG_INC(ll_hid_tx_down); }
    }
    RF_DIAG_SET(last_rf_op, 3);
    RF_Shut();
#if !STOCK_RESP_NO_SETCH
    /* Redundant: the radio is already on the poll channel from rf_start_rx, and
     * re-setting it forces a ~150us PLL relock -- pushing the response outside the
     * stock dongle's post-poll RX window. The stock keyboard (firmwareB.bin
     * 0x20000f06) TXes the response with NO RF_SetChannel for exactly this reason. */
    RF_SetChannel(response_channel);
#endif
    uint8_t tx_status = RF_Tx(tx_payload, tx_len, 0xFF, 0xFF);
    RF_DIAG_SET(rf_last_tx_status, tx_status);
    if (tx_status == 0 && tx_len == 10) {
        /* Only a STARTED transmission makes this head eligible for ack-retire.
         * Not cleared on failure: an earlier successful send of the same head
         * keeps its eligibility (codex). */
        hid_head_sent = 1;
        if (sel_down) {
            hid_tx_down_inflight = 1;   /* TX started; TX_FINISH counts it as on-air */
        }
    }
    RF_DIAG_INC(rf_connected_tx_count);
    if (tx_status != 0) {
        /* TX did not start -> no TX_FINISH will come; don't block the hop. */
        response_pending = 0;
        rf_set_event_atomic(RF_EVT_RX_RESTART);
    }
}

static uint16_t RF_ProcessEvent(uint8_t task_id, uint16_t events)
{
    if (events & SYS_EVENT_MSG) {
        uint8_t *msg = tmos_msg_receive(task_id);
        if (msg != NULL) {
            tmos_msg_deallocate(msg);
        }
        return events ^ SYS_EVENT_MSG;
    }

    if (events & RF_EVT_START) {
        rf_state = RF_STATE_IDLE;
        rf_access_addr = RF_DEFAULT_ACCESS_ADDR;
        rf_channel = pair_channels[0];
        RF_Shut();
        return events ^ RF_EVT_START;
    }

    if (events & RF_EVT_RX_RESTART) {
        /* In PAIRING the re-arm is gated by pair_rx_open: after the duty
         * cycle's RX_OFF closed the window, a stale RX_RESTART (late
         * TX-finish or RX-error callback) must not reopen the receiver for
         * the rest of the beacon period. CONNECTED is unconditional. */
        if (rf_state == RF_STATE_CONNECTED
                || (rf_state == RF_STATE_PAIRING && pair_rx_open)) {
            rf_start_rx(rf_channel);   /* re-arm on the current channel */
#if KBD_PAIR_DUTY_CYCLE
            /* Start the close timer from the moment RX actually arms (first
             * restart of this beacon epoch only), so the full window is
             * armed listen time regardless of beacon airtime or scheduler
             * latency (review finding). */
            if (rf_state == RF_STATE_PAIRING
                    && pair_flavor == PAIR_FLAVOR_BONDED
                    && !pair_rx_off_armed) {
                pair_rx_off_armed = 1;
                rf_start_task_atomic(RF_EVT_PAIR_RX_OFF,
                                     KBD_PAIR_RX_WINDOW_TICKS);
            }
#endif
        }
        return events ^ RF_EVT_RX_RESTART;
    }

    if (events & RF_EVT_PAIR_BCAST) {
        if (rf_state == RF_STATE_PAIRING) {
            rf_pair_broadcast();
        }
        return events ^ RF_EVT_PAIR_BCAST;
    }

    if (events & RF_EVT_PAIR_RX_OFF) {
        /* Close the bonded-reconnect listen window until the next beacon.
         * A LEN-15 already caught has posted ENTER_CONNECTED, whose handler
         * re-arms RX itself, so shutting here can never lose the catch. */
        if (rf_state == RF_STATE_PAIRING
                && pair_flavor == PAIR_FLAVOR_BONDED) {
            pair_rx_open = 0;
            pair_rx_off_armed = 0;
            RF_Shut();
            RF_DIAG_INC(pwr_pair_rx_off_count);
        }
        return events ^ RF_EVT_PAIR_RX_OFF;
    }

    if (events & RF_EVT_PAIR_TIMEOUT) {
        if (rf_state == RF_STATE_PAIRING) {
            rf_state = RF_STATE_IDLE;
            rf_stop_task_atomic(RF_EVT_PAIR_RX_OFF);
            RF_Shut();
        }
        return events ^ RF_EVT_PAIR_TIMEOUT;
    }

    if (events & RF_EVT_ENTER_CONNECTED) {
        rf_enter_connected();
        return events ^ RF_EVT_ENTER_CONNECTED;
    }

    if (events & RF_EVT_RESPOND) {
        /* In STOCK_ISR_FAST_RESPONSE builds the TMR0 ISR TXes directly and never
         * posts this event; this main-loop path is the default (deferred) one. */
        if (!STOCK_ISR_FAST_RESPONSE && rf_state == RF_STATE_CONNECTED) {
            rf_do_response_tx();
        }
        return events ^ RF_EVT_RESPOND;
    }

    if (events & RF_EVT_NOTIFY_LED) {
        /* One read, so the byte recorded as sent is the byte sent. The RX ISR
         * compares a new relay with last_led_sent, so one stored before the
         * record below may not have posted this event: look again. */
        uint8_t led = pending_led;
        if (led != last_led_sent) {
            KeyboardUart_SendLed(led);
            last_led_sent = led;
            if (pending_led != led) {
                rf_set_event_atomic(RF_EVT_NOTIFY_LED);
            }
        }
        return events ^ RF_EVT_NOTIFY_LED;
    }

    if (events & RF_EVT_DISCARD_HID) {
        if (rf_state == RF_STATE_IDLE) {
            rf_discard_hid_queue();
        }
        return events ^ RF_EVT_DISCARD_HID;
    }

    if (events & RF_EVT_SAVE_BOND) {
        rf_save_bond_to_flash();
        return events ^ RF_EVT_SAVE_BOND;
    }

#if KBD_REST
    if (events & RF_EVT_REST_IDLE) {
        if (rf_state == RF_STATE_CONNECTED && !rest_probe) {
            /* A held key produces no reports, so it never restarts this
             * timer; resting on it would have the dongle release it at the
             * host (keys-up on the lapse) while the user still holds it --
             * bench 2026-09-13: a 7 s hold was released at T_idle, auto-repeat
             * and all. Keep the link while the newest report holds anything;
             * the release restarts the full T_idle through rest_arm_idle. */
            if (hid_fifo_tail == hid_fifo_head && !response_pending && !hid_key_held()) {
                rest_enter();
            } else {
                rf_start_task_atomic(RF_EVT_REST_IDLE, KBD_REST_IDLE_RETRY_TICKS);
            }
        }
        return events ^ RF_EVT_REST_IDLE;
    }

    if (events & RF_EVT_REST_PROBE) {
        if (rf_state == RF_STATE_RESTING && rest_stage == 1u) {
            /* Cadence is start-to-start: re-arm before the probe so its own
             * duration never stretches the period the dongle measures. */
            rf_start_task_atomic(RF_EVT_REST_PROBE, KBD_REST_PROBE_TICKS);
            rest_probe_start();
        }
        return events ^ RF_EVT_REST_PROBE;
    }

    if (events & RF_EVT_REST_PROBE_TIMEOUT) {
        if (rest_probe) {
            if (rest_probe_wake) {
                /* A host report is waiting: keep searching (the beacon loop is
                 * still running) rather than give up; the catch keeps the session. */
                rf_start_task_atomic(RF_EVT_REST_PROBE_TIMEOUT, KBD_REST_PROBE_TIMEOUT_TICKS);
            } else {
                rest_probe_end(0u);
            }
        }
        return events ^ RF_EVT_REST_PROBE_TIMEOUT;
    }

    if (events & RF_EVT_REST_STAGE2) {
        if (rest_stage == 1u) {
            rest_stage = 2u;
            rf_stop_task_atomic(RF_EVT_REST_PROBE);
            RF_DIAG_INC(rest_stage2_entries);
        }
        return events ^ RF_EVT_REST_STAGE2;
    }
#endif

    if (events & RF_EVT_DISCONNECT) {
        if (rf_state == RF_STATE_CONNECTED) {
#if RF_DIAG_COUNTERS
            /* Drop snapshot (Codex): capture the keyboard's lock state at the moment
             * supervision fires. High since_rx => keyboard stopped hearing polls
             * (lost lock / dongle stopped). idx/channel = where it was when it lost
             * it. rtc lets us correlate against the dongle's last_rx_rtc. */
            ll_drop_count++;
            uint32_t drtc = rtc_read_32k();
            if (ll_drop_count == 1) {
                ll_drop1_since_rx = since_rx; ll_drop1_idx = prev_data_idx;
                ll_drop1_channel = rf_channel; ll_drop1_provis = provisional;
                ll_drop1_rtc = drtc;
            }
            ll_dropN_since_rx = since_rx; ll_dropN_idx = prev_data_idx;
            ll_dropN_channel = rf_channel; ll_dropN_provis = provisional;
            ll_dropN_rtc = drtc;
#endif
#if KBD_REST
            rest_cancel();
#endif
            rf_tmr0_stop();
            response_pending = 0;
            hid_head_sent = 0;   /* nothing is in flight across a teardown (codex) */
            /* The dongle releases every key on the host when it lapses, so the
             * newest queued state no longer describes the host: the next report
             * must be queued even when it repeats it (the host driver re-asserts
             * a held key after the reconnect). */
            hid_last_queued_valid = 0;
            bond_save_pending = 0;
            rf_state = RF_STATE_IDLE;
            RF_Shut();
            /* Clean teardown to IDLE + 5B33; the host paces the reconnect with
             * A6 30. (Firmware-side immediate auto-re-pair livelocks: it re-pairs
             * faster than the dongle can settle into connected polling.) */
            KeyboardUart_SendStatus(0x33);
        }
        return events ^ RF_EVT_DISCONNECT;
    }

    return 0;
}

static uint8_t rf_configure(uint32_t access_addr)
{
    rfConfig_t cfg;

    tmos_memset(&cfg, 0, sizeof(cfg));
    cfg.LLEMode = RF_LLE_MODE;
    cfg.Channel = 0;
    cfg.accessAddress = access_addr;
    cfg.CRCInit = RF_CRC_INIT;
    cfg.rfStatusCB = RF_2G4StatusCallBack;
    cfg.RxMaxlen = RF_RX_MAX_LEN;

    RF_DIAG_INC(rf_config_count);
    uint8_t cfg_status = RF_Config(&cfg);
    RF_DIAG_SET(rf_last_config_status, cfg_status);
    RF_SetChannel(rf_channel);
    return cfg_status;
}

/* [STEP1 experiment] RF_Config re-inits the RF/LLE stack and only needs to run
 * when the access address changes (pairing AA -> connected session AA). Calling
 * it on every ~17ms hop re-arm is the suspected v1.4.2 TMOS-timer-list corruption
 * trigger (RF-stack re-entry racing the LLE/TMOS scheduler). Config once per AA;
 * between hops just retune. (The connected response-TX path already skips
 * RF_Config for the same reason -- see the RF_EVT_RESPOND handler.) */
static uint32_t rf_configured_aa;
/* Explicit validity flag instead of any in-band sentinel value: every
 * sentinel scheme collides with SOME legal AA (0 with a zero/corrupt AA,
 * a complement scheme with an AA equal to the previous one's complement),
 * and the cost of the collision is a radio silently left unconfigured
 * (review finding). */
static uint8_t rf_configured_valid;
static void rf_configure_if_needed(uint32_t access_addr)
{
    if (!rf_configured_valid || rf_configured_aa != access_addr) {
        uint8_t cfg_status = rf_configure(access_addr);
        if (cfg_status == 0) {
            rf_configured_aa = access_addr;
            rf_configured_valid = 1;
        }
    } else {
        RF_SetChannel(rf_channel);   /* same AA: retune only, no RF_Config */
    }
}

__HIGH_CODE
static void rf_start_rx(uint8_t channel)
{
#if RF_DIAG_COUNTERS
    uint8_t diag_connected = (rf_state == RF_STATE_CONNECTED);
    uint32_t diag_begin_sys = diag_connected ? systick_read() : 0u;
#endif
    RF_DIAG_SET(last_rf_op, 1);
    RF_Shut();
    /* Commit rf_channel WHILE the radio is shut (R1): rf_channel is the channel
     * RX is physically armed on, and the RX ISR latches response_channel from it
     * (line ~311). Assigning it only here -- after RF_Shut, before the RF_Rx
     * re-arm -- guarantees a poll can never latch a look-ahead channel the radio
     * is not yet tuned to. The caller passes the target channel instead of
     * pre-setting rf_channel. */
    rf_channel = channel;
    rf_configure_if_needed(rf_access_addr);   /* RF_Config only on AA change; else retune */
    uint8_t rx_status = RF_Rx(NULL, 0, 0xFF, 0xFF);
    RF_DIAG_SET(rf_last_rx_status, rx_status);
#if RF_DIAG_COUNTERS
    if (diag_connected) {
        ll_record_rx_rearm_gap(diag_begin_sys, systick_read());
    }
#endif
}

static void rf_pair_broadcast(void)
{
    if (!keyboard_mac_valid) {
        rf_state = RF_STATE_IDLE;
        RF_Shut();
        return;
    }
    RF_DIAG_SET(last_rf_op, 2);
    uint8_t dwell = (uint8_t)(pair_bcast_count / RF_PAIR_DWELL_BCASTS);
    uint8_t pair_channel_idx = (uint8_t)(dwell % NUM_PAIR_CHANNELS);

    rf_channel = pair_channels[pair_channel_idx];

    for (uint8_t i = 0; i < 6; i++) {
        pair_payload[i] = keyboard_mac[i];
    }
    pair_payload[6] = (uint8_t)(RF_PAIR_INTERVAL & 0xFF);
    pair_payload[7] = (uint8_t)(RF_PAIR_INTERVAL >> 8);
    pair_payload[8] = (uint8_t)(RF_PAIR_TIMEOUT_VALUE & 0xFF);
    pair_payload[9] = (uint8_t)(RF_PAIR_TIMEOUT_VALUE >> 8);

    RF_Shut();
    rf_configure_if_needed(rf_access_addr);
    uint8_t tx_status = RF_Tx(pair_payload, sizeof(pair_payload), 0xFF, 0xFF);
    RF_DIAG_SET(rf_last_tx_status, tx_status);

    RF_DIAG_INC(rf_pair_bcast_count);
    pair_bcast_count++;
    rf_start_task_atomic(RF_EVT_PAIR_BCAST, RF_PAIR_BCAST_TICKS);

    /* Open the post-beacon listen window (TX_FINISH -> RX_RESTART arms the
     * receiver). Bonded reconnect closes it again KBD_PAIR_RX_WINDOW_TICKS
     * after RX actually arms -- the close timer is started by the first
     * RX_RESTART of this epoch (see the handler), not here, so beacon
     * airtime and TMOS dispatch latency never eat the listen window (review
     * finding). Fresh pairing leaves the window open until the next
     * beacon's RF_Shut, exactly as before this rung. The stop_task clears
     * a fired-but-unhandled RX_OFF from a delayed previous epoch, which
     * would otherwise close THIS epoch's window (review finding; TMOS
     * stop_task clears queued event bits too). */
    rf_stop_task_atomic(RF_EVT_PAIR_RX_OFF);
    pair_rx_open = 1;
    pair_rx_off_armed = 0;
}

static void rf_enter_connected(void)
{
    /* Belt-and-braces vs a stale queued catch: every user transition that
     * invalidates a pending catch (A6 52/11 -> RF_Disconnect, A6 51/63 ->
     * RF_EnterPairing) now also clears the queued ENTER_CONNECTED event, so
     * reaching here outside PAIRING should be impossible -- but a catch
     * connecting from IDLE with torn-down pending_* state is bad enough to
     * guard anyway (adversarial-review finding: the RX_OFF event can defer
     * a catch by one scheduler pass, widening the pre-existing window). */
    if (rf_state != RF_STATE_PAIRING) {
        return;
    }
    RF_DIAG_INC(entered_connected_count);
#if KBD_REST
    /* A silent probe: the RF side connects exactly as usual, but the keyboard
     * MCU is told nothing (it still sees the session) and last_led_sent is kept
     * so only a real LED change is relayed. The dongle re-relays its LED byte
     * on every promote, so a resting keyboard still tracks host LED state. */
    uint8_t silent_probe = (uint8_t)(rest_probe && !rest_probe_wake);
#endif
    /* Only ever reached from PAIRING (the connected path drops LEN-15 re-keys), so
     * this is always a real IDLE/PAIRING->CONNECTED transition -- announce 5B32. */
    rf_stop_task_atomic(RF_EVT_PAIR_BCAST);
    rf_stop_task_atomic(RF_EVT_PAIR_TIMEOUT);
    rf_stop_task_atomic(RF_EVT_PAIR_RX_OFF);

    stored_session_aa = pending_session_aa;
    stored_type_tag = pending_type_tag;
    rf_access_addr = stored_session_aa;
    rf_conn_interval = pending_interval;
    prev_data_idx = (uint8_t)((stored_type_tag + STOCK_CONNECT_IDX_BIAS) % NUM_DATA_CHANNELS);
    tx_ctrl = 0x02;
    /* New session: the control phase restarts, so no queued entry has been
     * transmitted under it yet. Keep the QUEUE (that is the whole point of the
     * fix -- a report queued while the link was down must survive), but drop
     * transmission eligibility so the first accepted poll of the new session
     * cannot retire an entry the peer never received (codex). */
    hid_head_sent = 0;
    hop_anchor = pending_anchor;   /* seeded at the 2nd 15-byte (rx-13) */
    since_rx = 0;
    response_pending = 0;
    provisional = 1;   /* park-and-listen until the first poll is caught */
#if KBD_REST
    bond_save_pending = (uint8_t)!silent_probe;   /* a probe rejoins the same bond: no DataFlash write per second */
#else
    bond_save_pending = 1;
#endif
    rf_state = RF_STATE_CONNECTED;

#if RF_DIAG_COUNTERS
    ll_trace_count = 0;
    ll_resp_suppressed = 0;
    ll_trace_armed = 1;   /* capture the first LL_TRACE_N connected callbacks */
#endif
    /* No active TMR0 here: the listen channel is advanced by elapsed RTC time in
     * RF_ConnectedTick(), polled from the main loop (stock 0x20000E06 model). */
    rf_tmr0_stop();
    rf_start_rx(data_channels[prev_data_idx]);
    PFIC_EnableIRQ(TMR0_IRQn);   /* TMR0 = post-poll response turnaround timer */
    rf_stop_task_atomic(RF_EVT_DISCONNECT);   /* reset, don't double-arm a stale timer */
    rf_start_task_atomic(RF_EVT_DISCONNECT, RF_CONNECTED_TIMEOUT_TICKS);

#if KBD_REST
    if (silent_probe) {
        return;                       /* KBD_REST_PROBE_TIMEOUT bounds the probe */
    }
    if (rest_probe) {
        rest_promote_to_normal();     /* a key woke us: this connection is the session */
        return;
    }
#endif
    KeyboardUart_SendStatus(0x32);
    KeyboardUart_SendStatus(0x23);
    /* The host's LED state is the dongle's to tell: it relays it on connect.
     * Forward that relay whatever its value, and leave the host's LEDs alone
     * until it comes. A 5A 00 here showed Caps Lock off until then, and for
     * good behind a dongle that never re-sent it on a reconnect. */
    last_led_sent = 0xFF;
#if KBD_REST
    rest_arm_idle();
#endif
}

/* Time-based connected-mode hop (stock firmwareB.bin 0x20000E06). Polled from
 * the main loop every iteration. When at least one conn-interval of RTC32K time
 * has elapsed since the anchor, advance the LISTEN channel by elapsed/interval
 * data channels and retune RX. Because the channel is driven by ELAPSED TIME
 * (not by catching a poll), it keeps following the dongle's hop through missed
 * polls; the PLL servo in the RX path keeps it phase-locked. */
__HIGH_CODE
void RF_ConnectedTick(void)
{
    uint32_t now;
    uint32_t elapsed;
    uint16_t interval;
    uint32_t step;
    uint32_t irq;
    uint8_t  advanced = 0;

    if (rf_state != RF_STATE_CONNECTED) {
        return;
    }
    RF_DIAG_INC(connected_tick_calls);   /* hop code past the state gate actually ran */
#if KBD_REST
    if (rest_quiet_pending && !response_pending) {
        rest_probe_end(1u);
        return;
    }
#endif

    /* Re-arm the connection-supervision timer here (main-loop context) when the
     * RX ISR flagged an incoming poll. Placed BEFORE the response_pending
     * early-return so supervision always resets promptly. This is the deferred
     * counterpart to the old ISR-context tmos_start/stop_task (the HardFault fix). */
    if (supervision_kick) {
        supervision_kick = 0;
        rf_stop_task_atomic(RF_EVT_DISCONNECT);
        rf_start_task_atomic(RF_EVT_DISCONNECT, RF_CONNECTED_TIMEOUT_TICKS);
    }

    interval = rf_conn_interval ? rf_conn_interval : RF_PAIR_INTERVAL;

    /* Don't retune/shut the radio while a response is pending (the latched TX
     * owns the radio until TX_FINISH) -- BUT a lost/late TX_FINISH must NOT stall
     * the hop, or the keyboard freezes on one channel and loses lock. Force-
     * release after 2 intervals so the hop keeps following and re-acquires. */
    if (response_pending) {
        if (rtc_delta_32k(rtc_read_32k(), response_armed_rtc) <=
            (uint32_t)interval * 2u) {
            return;
        }
        response_pending = 0;
    }

    /* Critical section (stock runs its hop scheduler with IRQ save/restore): the
     * RX-ISR servo and this advance both read-modify-write hop_anchor/since_rx,
     * so disable IRQs while we touch them. Keep rf_start_rx() OUT of the critical
     * section (stock defers the RX arm to event 0x04). */
    irq = rf_irq_save();
    now = rtc_read_32k();
    elapsed = rtc_delta_32k(now, hop_anchor);
    if (provisional) {
        /* PARK on the seed channel: keep prev_data_idx fixed, so we dwell on one
         * channel and the dongle's sweep lands on us. The default build re-arms
         * RX once per interval; STOCK_CONTINUOUS_PARK_ACQ keeps RX continuously
         * open to test whether those re-arm gaps hide stock polls. */
        if (elapsed > interval) {
            hop_anchor = rtc_add_32k(hop_anchor, interval);
#if !STOCK_CONTINUOUS_PARK_ACQ
            advanced = 1;
#endif
        }
    } else if (elapsed > (uint32_t)interval * RF_HOP_DESYNC_INTERVALS) {
        /* Desync safety-net (rare): a >64-interval gap -- the anchor raced ahead,
         * or RF_ConnectedTick did not run for tens of ms. Re-seed the phase to
         * now-backdate so the hop stops free-running. This corrects PHASE only,
         * NOT the channel index: the RX servo nudges hop_anchor and clears
         * provisional but never re-writes prev_data_idx (only the normal hop
         * branch advances it). It also cannot recover a main-loop stall -- by the
         * time a >64-interval (~56 ms) gap accrues, the keyboard has been silent
         * long enough that the dongle's own ~26-poll (~22 ms) supervision has
         * already dropped the link, so recovery is the IDLE->reconnect path, not
         * this branch. (Park-and-snap here -- provisional=1 -- was tried on the
         * bench and measured to add nothing, for exactly that reason.) */
        hop_anchor = rtc_backdate_32k(now, RF_HOP_ANCHOR_BACKDATE);
        RF_DIAG_INC(ll_desync_reseed);
        advanced = 1;   /* re-arm RX on the current channel so we can re-catch */
    } else if (elapsed > interval) {
        step = elapsed / interval;
        if (step > RF_HOP_MAX_STEP) {
            step = RF_HOP_MAX_STEP;   /* clamp a stale anchor; the servo re-locks the phase */
            RF_DIAG_INC(ll_step_clamp);
        }
        hop_anchor = rtc_add_32k(hop_anchor, (uint32_t)interval * step);
        prev_data_idx = (uint8_t)((prev_data_idx + step) % NUM_DATA_CHANNELS);
        /* rf_channel is committed in rf_start_rx() below (R1): keep it equal to
         * the radio's armed channel so the RX-ISR response_channel latch is correct */
        /* stock one-tick rollback on the slot immediately after an RX */
        if (step == 1u && since_rx == 1u) {
            hop_anchor = rtc_backdate_32k(hop_anchor, 1);
        }
        /* Keep drop diagnostics monotonic across long droughts; supervision
         * normally fires well before this saturates. */
        if (since_rx < 0xffffu) {
            since_rx++;
        }
#if RF_DIAG_COUNTERS
        if (since_rx > ll_since_rx_max) ll_since_rx_max = since_rx;
#endif
        advanced = 1;
    }
    rf_irq_restore(irq);

    if (advanced) {
        RF_DIAG_INC(hop_advance_count);   /* the RTC-timed hop actually retuned */
        if (response_pending) {
            return;
        }
        rf_start_rx(data_channels[prev_data_idx]);
    }
}

static void rf_tmr0_stop(void)
{
    PFIC_DisableIRQ(TMR0_IRQn);
    R8_TMR0_CTRL_MOD = 0;
    R8_TMR0_INTER_EN = 0;
    R8_TMR0_INT_FLAG = RB_TMR_IF_CYC_END;
    PFIC_ClearPendingIRQ(TMR0_IRQn);
}

/* Arm TMR0 as a one-shot: count to `count`, fire the cycle-end IRQ once. The IRQ
 * handler stops it (so it does not free-run) and posts the response event. Called
 * from the RX callback (ISR context) — register writes only. */
__HIGH_CODE
static void rf_tmr0_arm(uint32_t count)
{
    R8_TMR0_INTER_EN = 0;
    R32_TMR0_CNT_END = count;
    R8_TMR0_CTRL_MOD = RB_TMR_ALL_CLEAR;
    R8_TMR0_INT_FLAG = RB_TMR_IF_CYC_END;
    R8_TMR0_INTER_EN = RB_TMR_IF_CYC_END;
    R8_TMR0_CTRL_MOD = RB_TMR_COUNT_EN;
}

/* Post-poll turnaround timer (stock TMR0 IRQ at firmwareB.bin ~0x20001446):
 * stop the one-shot, then post the response event so the main loop TXes inside
 * the dongle's post-poll RX window. */
__INTERRUPT
__HIGH_CODE
void TMR0_IRQHandler(void)
{
    RF_DIAG_INC(tmr0_irq_count);
    if ((R8_TMR0_INT_FLAG & RB_TMR_IF_CYC_END) == 0) {
        return;
    }
    R8_TMR0_INT_FLAG = RB_TMR_IF_CYC_END;
    R8_TMR0_CTRL_MOD = 0;        /* one-shot: stop so it fires once per arm */
    if (rf_state == RF_STATE_CONNECTED) {
#if STOCK_ISR_FAST_RESPONSE
        rf_do_response_tx();     /* TX here (~5us post-poll) instead of ~275us via the main loop */
#else
        rf_set_event_atomic(RF_EVT_RESPOND);
#endif
    }
}

void RF_TaskInit(void)
{
    /* This runs after RF_RoleInit, matching WCH's own RF examples.  Failure
     * leaves the radio idle, but initialization continues so UART commands
     * (including OpenBoot entry) remain available. */
    rf_init_keyboard_identity();

#if RF_DIAG_COUNTERS
    for (uint8_t i = 0; i < 6; i++) {
        rf_cb_count[i] = 0;
    }
    rf_pair_bcast_count = 0;
    rf_connected_tx_count = 0;
    rf_valid_rx_count = 0;
    pwr_pair_rx_off_count = 0;
    rf_last_config_status = 0;
    rf_last_rx_status = 0;
    rf_last_tx_status = 0;
    tmr0_irq_count = 0;
    entered_connected_count = 0;
    connected_tick_calls = 0;
    hop_advance_count = 0;
    rf_config_count = 0;
    last_rf_op = 0;
    last_cb_state = 0;
    last_cb_sta = 0;
    cb_in_cs = 0;
    bb_cb_in_cs_count = 0;
    for (uint8_t i = 0; i < 5; i++) ll_kbd_rx_ch[i] = 0;
    ll_since_rx_max = 0; ll_desync_reseed = 0; ll_step_clamp = 0;
    ll_servo_plus = 0; ll_servo_minus = 0; ll_servo_noop = 0;
    ll_drop_count = 0; ll_drop1_rtc = 0; ll_dropN_rtc = 0;
    ll_drop1_since_rx = 0; ll_drop1_idx = 0; ll_drop1_channel = 0; ll_drop1_provis = 0;
    ll_dropN_since_rx = 0; ll_dropN_idx = 0; ll_dropN_channel = 0; ll_dropN_provis = 0;
    ll_trace_count = 0; ll_trace_armed = 0; ll_resp_suppressed = 0;
    ll_rx_rearm_count = 0; ll_rx_rearm_gap_last = 0; ll_rx_rearm_gap_min = 0;
    ll_rx_rearm_gap_max = 0; ll_rx_rearm_gap_sum = 0;
    ll_rx_rearm_begin_sys = 0; ll_rx_rearm_end_sys = 0;
    ll_rx_cb_last_sys = 0; ll_rx_since_rearm_sys = 0;
    ll_rx_rearm_last_idx = 0; ll_rx_rearm_last_channel = 0;
    ll_rx_rearm_last_provis = 0;
    ll_boot_count++;   /* NOT zeroed: counts RF_TaskInit runs to detect reboots mid-test */
#endif

    rf_taskID = TMOS_ProcessEventRegister(RF_ProcessEvent);
    if (rf_taskID == INVALID_TASK_ID) {
        while (1) {
        }
    }
    rf_state = RF_STATE_IDLE;
    rf_access_addr = RF_DEFAULT_ACCESS_ADDR;
    rf_configured_aa = 0;   /* force RF_Config on first RX/TX */
    rf_channel = pair_channels[0];
    rf_conn_interval = RF_PAIR_INTERVAL;
    pending_led = 0;
    last_led_sent = 0xFF;
    bond_save_pending = 0;
    rf_clear_bond_ram();
#if STOCK_SEED_BOND
    has_bond = 1;
    stored_session_aa = STOCK_SEED_SESSION_AA;
    stored_type_tag = (uint8_t)STOCK_SEED_TYPE_TAG;
    stored_dongle_mac[0] = STOCK_SEED_DONGLE_MAC_0;
    stored_dongle_mac[1] = STOCK_SEED_DONGLE_MAC_1;
    stored_dongle_mac[2] = STOCK_SEED_DONGLE_MAC_2;
    stored_dongle_mac[3] = STOCK_SEED_DONGLE_MAC_3;
    stored_dongle_mac[4] = STOCK_SEED_DONGLE_MAC_4;
    stored_dongle_mac[5] = STOCK_SEED_DONGLE_MAC_5;
#else
    (void)rf_load_bond_from_flash();
#endif
    tmos_memset(hid_fifo, 0, sizeof(hid_fifo));
    hid_fifo_head = 0; hid_fifo_tail = 0; hid_head_sent = 0;
    tmos_memset(hid_last_queued, 0, sizeof(hid_last_queued));
    hid_last_queued_valid = 0;
    if (has_bond && keyboard_mac_valid) {
        rf_state = RF_STATE_PAIRING;
        pair_flavor = PAIR_FLAVOR_BONDED;
        pair_rx_open = 1;
        pair_rx_off_armed = 0;
        rf_access_addr = stored_session_aa;
        /* Force the next rf_configure regardless of any cached AA value:
         * a zero or otherwise colliding session AA (STOCK_SEED_BOND or
         * corrupt RAM state, bench-diagnosed) must never skip RF_Config
         * and search on an unconfigured radio. Persisted bonds reject
         * zero/default AAs at load, so this is pure hardening. */
        rf_configured_valid = 0;
        rf_channel = pair_channels[0];
        pair_bcast_count = 0;
        rf_set_event_atomic(RF_EVT_PAIR_BCAST);
    } else {
        rf_set_event_atomic(RF_EVT_START);
    }
}

#if KBD_REST
/* Resting policy helpers (RESTING_POLICY.md). All main-loop context. */
static void rest_cancel(void)
{
    rf_stop_task_atomic(RF_EVT_REST_IDLE);
    rf_stop_task_atomic(RF_EVT_REST_PROBE);
    rf_stop_task_atomic(RF_EVT_REST_PROBE_TIMEOUT);
    rf_stop_task_atomic(RF_EVT_REST_STAGE2);
    rest_stage = 0; rest_probe = 0; rest_probe_wake = 0; rest_answers = 0;
    rest_quiet_pending = 0;
}

/* (Re)start the inactivity timer: on a real connect and on every host report. */
static void rest_arm_idle(void)
{
    if (rf_state == RF_STATE_CONNECTED && !rest_probe) {
        rf_stop_task_atomic(RF_EVT_REST_IDLE);
        rf_start_task_atomic(RF_EVT_REST_IDLE, KBD_REST_IDLE_TICKS);
    }
}

/* Radio off, no frame to anyone: the dongle lapses by its own supervision
 * (~19 ms after our last reply) into its bonded camp. */
static void rest_go_quiet(void)
{
    rf_tmr0_stop();
    rf_stop_task_atomic(RF_EVT_DISCONNECT);
    rf_stop_task_atomic(RF_EVT_PAIR_BCAST);
    rf_stop_task_atomic(RF_EVT_PAIR_RX_OFF);
    rf_stop_task_atomic(RF_EVT_PAIR_TIMEOUT);
    rf_stop_task_atomic(RF_EVT_ENTER_CONNECTED);
    rf_stop_task_atomic(RF_EVT_REST_PROBE_TIMEOUT);
    response_pending = 0;
    supervision_kick = 0;
    pair_rx_open = 0;
    pair_rx_off_armed = 0;
    rest_probe = 0; rest_answers = 0; rest_quiet_pending = 0; rest_probe_wake = 0;
    rf_state = RF_STATE_RESTING;
    RF_Shut();
}

static void rest_enter(void)
{
    RF_DIAG_INC(rest_entries);
    rest_go_quiet();
    rest_stage = 1;
    rf_start_task_atomic(RF_EVT_REST_PROBE, KBD_REST_PROBE_TICKS);
    rf_start_task_atomic(RF_EVT_REST_STAGE2, KBD_REST_STAGE2_TICKS);
}

/* One bonded reconnect: the RF_Select2G4 bonded branch, flagged as a probe so
 * the connect stays silent toward the MCU and ends after a couple of polls. */
static void rest_probe_start(void)
{
    if (!has_bond || !keyboard_mac_valid) {
        rest_cancel();                /* nothing to probe: the MCU will re-select */
        rf_state = RF_STATE_IDLE;
        RF_Shut();
        return;
    }
    RF_DIAG_INC(rest_probes);
    rest_probe = 1; rest_answers = 0; rest_quiet_pending = 0;
    rf_tmr0_stop();
    RF_Shut();
    rf_stop_task_atomic(RF_EVT_ENTER_CONNECTED);
    rf_state = RF_STATE_PAIRING;
    pair_flavor = PAIR_FLAVOR_BONDED;
    pair_rx_open = 1;
    pair_rx_off_armed = 0;
    rf_access_addr = stored_session_aa;
    rf_configured_valid = 0;
    rf_channel = pair_channels[0];
    pair_bcast_count = 0;
    rf_stop_task_atomic(RF_EVT_PAIR_TIMEOUT);
    rf_stop_task_atomic(RF_EVT_PAIR_RX_OFF);
    rf_set_event_atomic(RF_EVT_PAIR_BCAST);
    rf_stop_task_atomic(RF_EVT_REST_PROBE_TIMEOUT);
    rf_start_task_atomic(RF_EVT_REST_PROBE_TIMEOUT, KBD_REST_PROBE_TIMEOUT_TICKS);
}

static void rest_probe_end(uint8_t caught)
{
    if (caught) { RF_DIAG_INC(rest_probe_catches); } else { RF_DIAG_INC(rest_probe_misses); }
    rest_go_quiet();                  /* stage and the cadence timer are untouched */
}

/* A probe becomes the session: a host report arrived, or the host re-selected
 * 2.4G. Nothing is announced (the MCU already sees a connected link). */
static void rest_promote_to_normal(void)
{
    rf_stop_task_atomic(RF_EVT_REST_PROBE);
    rf_stop_task_atomic(RF_EVT_REST_PROBE_TIMEOUT);
    rf_stop_task_atomic(RF_EVT_REST_STAGE2);
    rest_stage = 0; rest_probe = 0; rest_probe_wake = 0; rest_answers = 0;
    rest_quiet_pending = 0;
    rf_stop_task_atomic(RF_EVT_DISCONNECT);
    rf_start_task_atomic(RF_EVT_DISCONNECT, RF_CONNECTED_TIMEOUT_TICKS);
    rest_arm_idle();
}
#endif /* KBD_REST */

/* The host left 2.4 GHz (SELECT_USB, or a BT select). What it queued for the
 * link and never got out must not type itself out when 2.4 GHz next connects,
 * long after the host moved on. Unless a SELECT_2G4 follows within
 * KBD_RESELECT_KEEP_TICKS (RF_Select2G4 cancels this): that was a forced
 * reconnect, and the reports are still wanted. Call after RF_Disconnect(). */
void RF_DropQueueUnlessReselected(void)
{
    rf_stop_task_atomic(RF_EVT_DISCARD_HID);
    rf_start_task_atomic(RF_EVT_DISCARD_HID, KBD_RESELECT_KEEP_TICKS);
}

uint8_t RF_Select2G4(void)
{
    rf_stop_task_atomic(RF_EVT_DISCARD_HID);   /* a forced reconnect keeps the queue */
    if (!keyboard_mac_valid) {
        return 0;
    }
    if (rf_state == RF_STATE_CONNECTED) {
#if KBD_REST
        if (rest_probe) {
            rest_probe_wake = 1;
            rest_quiet_pending = 0;
            rest_promote_to_normal();   /* the host re-selected 2.4G during a probe: keep it */
        }
#endif
        return has_bond;
    }
#if KBD_REST
    rest_cancel();                      /* from RESTING or a probe search: a normal bonded reconnect follows */
#endif

    if (has_bond) {
        rf_tmr0_stop();
        /* Quiesce-then-sweep, mirroring RF_EnterPairing (review finding):
         * an A6 51 fresh-pair window may be live here, and a fresh catch
         * posted microseconds ago -- possibly from a DIFFERENT dongle in
         * accept mode -- would otherwise survive this bonded re-entry,
         * pass the PAIRING guard, and connect against the host's A6 30
         * intent. A swept same-bond catch just re-catches on the next
         * beacon (<= 20 ms). */
        RF_Shut();
        rf_stop_task_atomic(RF_EVT_ENTER_CONNECTED);
        rf_state = RF_STATE_PAIRING;
        pair_flavor = PAIR_FLAVOR_BONDED;
        pair_rx_open = 1;
        pair_rx_off_armed = 0;
        rf_access_addr = stored_session_aa;
        /* Force the next rf_configure regardless of any cached AA value:
         * a zero or otherwise colliding session AA (STOCK_SEED_BOND or
         * corrupt RAM state, bench-diagnosed) must never skip RF_Config
         * and search on an unconfigured radio. Persisted bonds reject
         * zero/default AAs at load, so this is pure hardening. */
        rf_configured_valid = 0;
        rf_channel = pair_channels[0];
        pair_bcast_count = 0;
        rf_stop_task_atomic(RF_EVT_PAIR_TIMEOUT);
        rf_stop_task_atomic(RF_EVT_PAIR_RX_OFF);
        rf_set_event_atomic(RF_EVT_PAIR_BCAST);
    }
    return has_bond;
}

uint8_t RF_EnterPairing(void)
{
    /* A6 51 ("pair current transport") must NOT tear down a healthy link. A host
     * that reconnects with A6 30 + A6 51, or sends a stray/late A6 51 after a
     * bonded reconnect already entered CONNECTED, would otherwise kick us back to
     * default-AA pairing (rf_access_addr -> RF_DEFAULT_ACCESS_ADDR) while the
     * dongle keeps polling the session AA -> a silent phantom (the natural-drop
     * reconnect failure). Forcing a fresh pair while connected requires an
     * explicit unpair (A6 52) or disconnect first. Returns 0 when it ignored
     * the request, so the caller answers with the live link, not PAIRING. */
    if (!keyboard_mac_valid || rf_state == RF_STATE_CONNECTED) {
        return 0;                     /* request ignored: leave the rest timers alone */
    }
#if KBD_REST
    rest_cancel();
#endif
    rf_tmr0_stop();
    /* Quiesce-then-clear, IN THIS ORDER (review finding): the old bonded-AA
     * receiver can still be armed here, and a LEN-15 landing after a bare
     * event-clear would simply REPOST ENTER_CONNECTED and pass the state
     * guard (state is PAIRING again). RF_Shut first makes new posts
     * impossible; the stop_task then sweeps anything posted before it --
     * including a catch from microseconds ago (A6 63 clears the bond first,
     * so a stale bonded catch would connect on torn-down state, and even on
     * A6 51 it would announce a spurious 5B32 after the host saw 5B31). */
    RF_Shut();
    rf_stop_task_atomic(RF_EVT_ENTER_CONNECTED);
    rf_state = RF_STATE_PAIRING;
    pair_flavor = PAIR_FLAVOR_FRESH;   /* user-attended: continuous RX */
    pair_rx_open = 1;
    pair_rx_off_armed = 0;
    rf_access_addr = RF_DEFAULT_ACCESS_ADDR;
    rf_channel = pair_channels[0];
    pair_bcast_count = 0;
    rf_stop_task_atomic(RF_EVT_PAIR_RX_OFF);
    rf_set_event_atomic(RF_EVT_PAIR_BCAST);
    rf_start_task_atomic(RF_EVT_PAIR_TIMEOUT, RF_PAIR_WINDOW_TICKS);
    return 1;
}

void RF_Disconnect(void)
{
#if KBD_REST
    rest_cancel();
#endif
    /* Every caller of this (SELECT_USB/BT, unpair, factory pair, the update
     * path, explicit sleep) drops the link, so the dongle lapses and releases
     * every key on the host. The newest queued state no longer describes the
     * host, and keeping it would let the adjacent-duplicate check swallow a
     * re-press of the same key -- the same reason the supervision teardown
     * clears it. Callers that send a release barrier first are unaffected;
     * those that do not are the hole (CodeRabbit). */
    hid_last_queued_valid = 0;
    rf_tmr0_stop();
    rf_stop_task_atomic(RF_EVT_PAIR_BCAST);
    rf_stop_task_atomic(RF_EVT_PAIR_TIMEOUT);
    rf_stop_task_atomic(RF_EVT_PAIR_RX_OFF);
    rf_stop_task_atomic(RF_EVT_ENTER_CONNECTED);   /* stale-catch guard */
    rf_stop_task_atomic(RF_EVT_DISCONNECT);
    bond_save_pending = 0;
    rf_state = RF_STATE_IDLE;
    RF_Shut();
}

/* Perform the deferred bond save NOW if one is pending. Normally the save
 * runs as a TMOS event posted on the first caught connected poll; a
 * firmware-update request landing in that window would otherwise lose the
 * fresh bond, because RF_Disconnect() clears bond_save_pending. The write is
 * done SYNCHRONOUSLY here rather than by posting RF_EVT_SAVE_BOND: TMOS
 * services one event per scheduler pass, so a posted event can still be
 * queued - and lost - when the update path resets the chip. Main-loop
 * context only (same context the TMOS handler runs in). */
void RF_FlushBondSave(void)
{
    if (bond_save_pending) {
        bond_save_pending = 0;
        rf_save_bond_to_flash();
    }
}

void RF_ClearBond(void)
{
#if KBD_REST
    rest_cancel();
#endif
    rf_clear_bond_ram();
    bond_save_pending = 0;
    rf_clear_bond_flash();
    /* Without the bond nothing queued can go anywhere; a new pairing must not
     * type it out on its new host. Both callers disconnect first. */
    rf_stop_task_atomic(RF_EVT_DISCARD_HID);
    if (rf_state == RF_STATE_IDLE) {
        rf_discard_hid_queue();
    }
}

uint8_t RF_HasBond(void)
{
    return has_bond;
}

/* Deep-sleep gate (power ladder MR5): the radio is quiescent for a deep
 * sleep only in IDLE (radio shut, no TMOS deadlines the sleep could not
 * honor -- the idleCB receives the next deadline anyway), or in the
 * radio-off slice of a BONDED reconnect search (RX window closed by the
 * duty cycle; the 20 ms beacon timer is the TMOS deadline the idleCB gets).
 * CONNECTED and FRESH pairing are never sleepable, and a still-open RX
 * window means the radio is live. Pending catches need no extra check:
 * TMOS only invokes the idle callback when no event is runnable. */
uint8_t RF_CanDeepSleep(void)
{
    if (rf_state == RF_STATE_IDLE || rf_state == RF_STATE_RESTING) {
        return 1;   /* radio off between probes; the RTC deadline is the next probe */
    }
    if (rf_state == RF_STATE_PAIRING
            && pair_flavor == PAIR_FLAVOR_BONDED && !pair_rx_open) {
        return 1;
    }
    return 0;
}

uint8_t RF_IdentityValid(void)
{
    return keyboard_mac_valid;
}

void RF_QueueHIDReport(const uint8_t report[8])
{
    RF_DIAG_INC(ll_hid_rx);
    uint8_t changed = !hid_last_queued_valid;
    for (uint8_t i = 0; i < 8; i++) {
        if (hid_last_queued[i] != report[i]) {
            changed = 1;
        }
    }
    if (report[0]|report[1]|report[2]|report[3]|report[4]|report[5]|report[6]|report[7]) {
        RF_DIAG_INC(ll_hid_rx_down);
    }
    /* Enqueue every TRANSITION. Dedup only against the newest QUEUED state, so
     * down -> up -> same-down is preserved; an unchanged repeat adds nothing the
     * host does not already have. The entry is retired only by the dongle's ack,
     * so a key-down queued while the link is down survives the reconnect gap
     * instead of being overwritten by its own key-up. */
    if (changed) {
        if ((uint8_t)(hid_fifo_tail - hid_fifo_head) < HID_FIFO_SLOTS) {
            uint8_t *slot = hid_fifo[hid_fifo_tail & (HID_FIFO_SLOTS - 1u)];
            for (uint8_t i = 0; i < 8; i++) {
                slot[i] = report[i];
            }
            __sync_synchronize();       /* payload stores complete BEFORE publishing */
            hid_fifo_tail++;
            for (uint8_t i = 0; i < 8; i++) {
                hid_last_queued[i] = report[i];
            }
            hid_last_queued_valid = 1;
        } else {
            /* Full: coalesce onto the NEWEST queued entry instead of discarding
             * this report. Dropping it outright can strand a key forever -- fill
             * the ring while a key is held, drop the all-keys-up, and nothing
             * ever retries the release because the MCU only sends changes
             * (codex). Overwriting the newest sacrifices one intermediate
             * transition but guarantees the latest physical state is queued.
             * The newest is never the in-flight head while the ring is full. */
            uint8_t *slot = hid_fifo[(uint8_t)(hid_fifo_tail - 1u) & (HID_FIFO_SLOTS - 1u)];
            for (uint8_t i = 0; i < 8; i++) {
                slot[i] = report[i];
            }
            for (uint8_t i = 0; i < 8; i++) {
                hid_last_queued[i] = report[i];
            }
            /* Must be set here too, not just on the enqueue path: the teardown
             * clears it, so a report that arrives while the ring is full would
             * otherwise leave it false for good -- disabling the dedup AND
             * hid_key_held(), which would let the link rest under a held key,
             * the defect this gate exists to prevent (Copilot). */
            hid_last_queued_valid = 1;
            RF_DIAG_INC(ll_hid_fifo_drop);   /* a transition was coalesced away */
        }
    }
#if KBD_REST
    /* The policy defines activity as a VALIDATED host report, not as a changed
     * payload: an unchanged repeat must still restart the inactivity timer and
     * still wake a resting link. Only the FIFO enqueue above is payload-conditional. */
    {
        if (rf_state == RF_STATE_RESTING) {
            /* A key while resting: probe now (any stage) and keep the session. */
            RF_DIAG_INC(rest_key_wakes);
            rest_probe_wake = 1;
            rf_stop_task_atomic(RF_EVT_REST_PROBE);
            rf_stop_task_atomic(RF_EVT_REST_STAGE2);
            rest_probe_start();
        } else if (rest_probe) {
            RF_DIAG_INC(rest_key_wakes);
            rest_probe_wake = 1;
            rest_quiet_pending = 0;
            if (rf_state == RF_STATE_CONNECTED) {
                rest_promote_to_normal();
            }
        } else if (rf_state == RF_STATE_CONNECTED) {
            rest_arm_idle();
        }
    }
#endif
}

#if KBD_REST
/* True only while stage-1 probing is scheduled. Stage 2 has no probes, so the
 * fast heartbeat buys nothing there. */
uint8_t RF_RestProbing(void)
{
    return (uint8_t)(rest_stage == 1u);
}
#endif

void RF_LedResync(void)
{
    last_led_sent = 0xFF;   /* not a real LED byte: the next report re-notifies */
}

uint8_t RF_GetState(void)
{
    return rf_state;
}

int8_t RF_GetRSSI(void)
{
    return rf_rssi;
}
