openkeyboard-org/OpenController/(commit log)

2026-08-07 firmware: vendor WCH CH592 SDK subset and BLE library v1.4.2
    Vendor the third-party code the CH592F firmware builds against, so the
    tree compiles standalone:
    - vendor/wch-ch592-sdk/: subset of the WCH CH59x SDK (BLE HAL, the seven
    compiled StdPeriphDriver sources, all driver headers, libISP592.a, and
    RVMSIS core support) from WeActStudio.WCH-BLE-Core @ 1ee632c2, path
    Examples/CH592/ble/broadcaster/.
    - vendor/wch-ble-lib-v1.4.2/: WCH CH59x BLE library V1.4.2 triple
    (LIBCH59xBLE.a, CH59xBLE_LIB.h, ble_task_scheduler.S), byte-identical
    to the openwch/ch592 EVT release.
    Every file copied verbatim and verified by sha256 against its source.
    NOTICE scopes the Apache-2.0 license to first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
2026-08-07 firmware: import CH592F keyboard controller application
    Import the keyboard-side CH592F firmware from the OpenDongle Controller
    prototype at 7caff2039bd3cc524902ce702268dce7670057bd: the 2.4 GHz
    wireless link (pairing, connected-mode channel hopping, HID uplink,
    DataFlash bond persistence), host UART protocol, phased startup, and
    fault handlers.
    Code is unchanged from the prototype; edits are packaging only:
    - Makefile paths point at the vendored SDK/BLE lib and ld/ch592f.ld;
    minichlink resolves from PATH; the bench probe serial default is gone
    (KBD_PROBE optional with a single probe); flash targets renamed to
    flash-app/flash-bare and the legacy wlink target dropped.
    - Bench-only int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
    [keyboard_uart.c, keyboard_uart.h, main.c, rf_task.c, rf_task.h]
2026-08-07 firmware: add build docs and SDK-alignment review
    Add firmware/README.md covering the MounRiver/WCH GCC12 toolchain
    requirement, build and flash workflow, the 0x1000 app slot flash map,
    and the validated-default build knobs. Carry docs/TMOS_REVIEW.md from
    the prototype (cited by Makefile and rf_task.c comments as the rationale
    for the interrupt architecture), with machine-local references scrubbed.
    Point the top-level README at the firmware and its vendor licensing
    terms.
2026-08-07 firmware: address review feedback on docs, licensing scope, and linker guard
    - Guard .diag_safe against silent stack overlap with a link-time ASSERT
    (the section is at 0x1c8 of its 0x200 window, so the guard has real
    headroom value). Verified: the .bin is still bit-identical to the
    prototype baseline (sha256 98732d4c...).
    - State the startup-file licensing exception consistently: the WCH-derived
    startup_CH592_phased.S is excluded from the Apache-2.0 first-party list
    in firmware/README.md and called out in the top-level README licensing
    section.
    - Complete the vendor checksum manifest (ble_task_scheduler.S), state its
    scope, and record that CH59x_i2c.h ships upstream without the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
2026-08-07 firmware: adopt OpenBoot A/B bootloader (CH592F, UART transport)
    Replace the stock vendor boot chain (app @0x1000, trampoline @0x0,
    vendor stage-1 @0x6D000, IAP staging) with OpenBoot: bootloader at
    [0, 0x2000), two 216 KiB application slots (A @0x2000, B @0x39000),
    per-slot OBR2 boot records, and the OBP update protocol over the
    module's existing UART1 pins (PB12/PB13, 115200 8N1).
    - third_party/openboot submodule pinned at the opencontroller-ch592
    board revision; slot geometry derived from the submodule at parse
    time (openboot_geometry.py), never hardcoded.
    - ld/ch592f.ld: MEMORY generated per slot into $(BUILD)/memory.ld;
    RAM shrinks 16 B (stack top 0x200067F0) for OpenBoot's boot-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
    [kbd_image_id.c, kbd_image_id.h, keyboard_uart.c, keyboard_uart.h, main.c, openboot_geometry.py, rf_task.c, rf_task.h]
2026-08-07 firmware: fix OpenBoot handoff wedge, harden bench update flow, add BOOT.md
    Bench bring-up on the CH592F fixture surfaced three issues, all fixed and
    re-validated on hardware:
    - SysTick handoff wedge: OpenBoot leaves SysTick free-running for its
    idle timeout; CH59x_BLEInit enables the SysTick IRQ one line before
    PFIC disables it, and the inherited pending count-flag fired in that
    window into the startup's weak infinite-loop handler. main() now stops
    the counter and clears pending state before the HAL runs. Diagnosed
    via new BOOT_PHASE markers (0xA0..0xA7 at 0x20005800, continuing the
    startup's 0xC0..0xC5 series) - kept, they make any future wedge
    SWD-attributable.
    - Post-reset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
    [main.c]
2026-08-07 firmware: address PR review and Codex adversarial findings
    Codex adversarial review (high): the deferred bond-save flush was not
    guaranteed - RF_FlushBondSave posted a TMOS event, but TMOS services one
    event per scheduler pass, so a competing RF event could leave the save
    queued when the update path reset the chip, losing a fresh bond.
    The flush now writes DataFlash synchronously (same function, same
    main-loop context as the TMOS handler), which also removes the
    scheduler-ordering constraint and a service state.
    Codex correction: the SysTick wedge's mechanism was misattributed. The
    bootloader stops the counter before ob_jump_app; what survives is the
    latched count-flag/PFIC pending state. T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
    [kbd_image_id.c, main.c, openboot_geometry.py, rf_task.c]
2026-08-08 firmware: bump OpenBoot pin to the opencontroller-ch592 board merge
    OpenBoot PR #13 merged as 60a100d1; the submodule and
    OPENBOOT_REVISION move from the PR head to the merge commit, closing
    the last open review item on this PR. No bootloader-relevant source
    changed between the two revisions (the delta is the board-config test
    and a README line), and both slot binaries rebuilt bit-identical at
    the new pin. check-deps, the factory compose (229,408 B with manifest
    revision assert), and OpenBoot's own test suite are green at the
    pinned commit.
2026-08-08 firmware: fingerprint the compiler via the resolved path; assert the header LMA
    Follow-up review round:
    - CCVER in CONFIG_FINGERPRINT invoked $(MRS_TOOLCHAIN)/$(CC), which
    breaks when CC is overridden to an absolute path or wrapper - the
    version silently drops out of the fingerprint and objects from a
    different compiler can be reused. CC_FOR_VERSION now uses CC as-is
    when it contains a slash and resolves it against MRS_TOOLCHAIN
    otherwise (a bare invocation was rejected: whether make's exported
    PATH prepend reaches $(shell) is version-dependent, and the wrong
    gcc fingerprinting quietly is the exact failure being guarded).
    - The identity header's placement is now asserted on it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
2026-08-09 firmware: default to WCH GCC15, keep GCC12 as the supported alternate
    MRS_TOOLCHAIN now defaults to the MounRiver 'RISC-V Embedded GCC15' install
    (riscv32-wch-elf-gcc 15.2.0); WCH GCC12 stays fully supported via a single
    MRS_TOOLCHAIN override. MounRiver renamed the tool prefix at GCC15
    (riscv-wch-elf-* -> riscv32-wch-elf-*), so the Makefile probes the install
    for the prefix instead of hardcoding one - the same probe OpenBoot runs.
    The probe is only enforced when a goal needs the compiler, so a fresh
    checkout can still 'make clean' with no toolchain installed.
    The OpenBoot bootloader is deliberately NOT moved: OPENBOOT_TOOLCHAIN now
    defaults to the GCC12 install independently of MRS_TOOLCHA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
2026-08-09 firmware: record the reset-recovery result as a measurement artifact in BOOT.md
    The 'Known limits' bullet asserted a v0.96.x keyboard-reset link-recovery
    failure. That deterministic failure was traced to debugger perturbation
    (minichlink SDI reset + halt/resume reads induce a TMOS misaligned-load
    fault that does not occur in normal operation); a 1000-cycle randomized
    warm-reset soak with a clean USB-HID oracle recovered 999/1000 with the
    lone failure a marginal-delivery blip that still reached CONNECTED. The
    README's new bench note on probe-mediated resets references this section.
2026-08-09 firmware: exempt non-compiling goals from the app-toolchain probe
    PR review (Copilot + CodeRabbit): the parse-time gate exempted only
    'clean', so goals that never invoke the application compiler failed on a
    host without one - check-deps (whose contract explicitly says verifying a
    SHA must not require a toolchain), check-openboot-toolchain and the
    OpenBoot-only targets (they use OPENBOOT_TOOLCHAIN, gated separately),
    and the minichlink-only info/gdbserver helpers. Maintain the exemption
    as a goal list; the gate still fires when any requested goal compiles.
2026-08-11 firmware: add board profiles and the MK65MX Wireless module
    The firmware assumed one piece of hardware: UART1 remapped to PB12/PB13 and
    a fixed compiled-in 2.4 GHz identity. The MonacoKeys MK65MX Wireless needs
    neither — it routes UART1 on the CH592F's default PA8/PA9 because PB13 is the
    board's CHWAKE net, and each production module must pair as itself.
    A board profile owns every hardware-dependent choice shared by the
    application and its OpenBoot image, so selecting a profile is enough to
    produce a self-consistent factory image:
    - boards/*.mk, selected with BOARD= and defaulting to the existing
    opencontroller-ch592 module. Missing or non-boolean knobs are a parse-time
    error rather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
    [keyboard_uart.c, main.c, rf_task.c, rf_task.h]
2026-08-11 firmware: run the MK65MX core from the DC-DC converter
    The CH592 boots with the core on its LDO, which drops the difference between
    the cell and the core rail as heat. The MK65MX Wireless module populates the
    DC-DC inductor, so it can run the switching regulator instead — the point of
    fitting the part.
    This is a hardware claim rather than a preference, so it is a board-profile
    knob (KBD_DCDC_ENABLE) validated like the others: a missing or non-boolean
    value is a parse-time error. PWR_DCDCCfg self-guards only the silicon
    capability, reading ROM_CFG_ADR_HW and declining when bit 13 says the part
    cannot do DC-DC at all. Nothing in the chip can tell that a PCB simply did
    not populate the induc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
    [main.c]
2026-08-12 docs: survey power-saving options against link performance
    The firmware has never had its power behaviour written down, and the obvious
    changes are not the safe ones: the hop scheduler is polled from the main loop,
    so any sleep taken while connected can stall RF_ConnectedTick and drop the
    link -- the same failure the UART TX timeout already guards against.
    POWERSAVING.md records the baseline (60 MHz spin, no idle instruction,
    HAL_SLEEP compiled out, polled UART RX, no peripheral gating) and orders the
    options by that constraint rather than by size of saving:
    - Tier A, no link risk: park unused GPIOs, power down UNIT_SYS_LSE, gate
    unused peripheral clocks. Notes that PWR_PeriphClkCfg writ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
2026-08-27 fix: Cleanup copyright headers and use gitmodules for dependencies
    [kbd_image_id.c, kbd_image_id.h, keyboard_uart.c, keyboard_uart.h, main.c, openboot_geometry.py, rf_task.c, rf_task.h]
2026-09-02 firmware: KBD_DCDC_ENABLE bench knob for the DC-DC vs LDO power A/B
    Adapted from feat/dcdc-enable (288decb) without the board-profile system:
    a default-off #ifndef knob in main.c, enabled per build with
    EXTRA_CFLAGS=-DKBD_DCDC_ENABLE=1, following the existing bench-probe
    pattern. PWR_DCDCCfg(ENABLE) runs ahead of SetSysClock, matching WCH's
    BLE examples, so the supply transient is taken on the reset-default
    clock, away from the PLL.
    Purpose: POWERSAVING.md (PR #8) noted PR #7 enables DC-DC on the
    strength of the datasheet alone, with no bench figures. This branch
    takes those figures.
    Measured 2026-09-02 on a bare CH592F (DC-DC inductor populated),
    unbonded firmware, identical builds except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
    [main.c]
2026-09-02 firmware: enable the DC-DC converter by default
    The bench figures are in (see the previous commit): 5.03 mA vs 7.17 mA
    active on a directly USB-metered CH592F, a 29.8% cut in the chip's own
    draw, converter verified running via the boot-phase sentinel and the
    image verified in flash by readback. With the datasheet claim now
    confirmed on hardware, LDO-by-default wastes a third of the active
    budget on boards that fit the inductor.
    The polarity of the knob flips accordingly: a board without the DC-DC
    inductor must now opt out with EXTRA_CFLAGS=-DKBD_DCDC_ENABLE=0, and
    the comment says so -- PWR_DCDCCfg cannot detect a missing inductor
    (it only checks ROM_CFG_ADR_HW bit 13, the silicon capabilit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
    [main.c]
2026-09-02 build: bump OpenBoot to 235486da for the MK65MX bootloader board
    The board-profiles commit documented this as its follow-up: the MK65MX
    profile needs openkeyboard-org/OpenBoot#20 (OB_UART1_ALT_PINS_HIZ and
    the mk65mx-wireless-ch592 board), which merged upstream on 2026-08-10
    but the pin here was never moved. Without it the mk65mx profile cannot
    compute slot geometry, so it neither builds nor passes the host tests.
    The bump also carries OpenBoot #14/#15 (v0.11 refactor + review fixes),
    #17 (bl_version derivation), and #19 (reset-state SysTick at handoff;
    the app-side pending-clear workaround in main.c stays, harmless).
    Deliberately pinned to the #20 merge rather than upstream HEAD: the
    later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
2026-09-02 firmware: reject KBD_DCDC_ENABLE in EXTRA_CFLAGS; opencontroller runs DC-DC
    Two changes prompted by the PR #7 review and the bench session:
    Reject -DKBD_DCDC_ENABLE inside EXTRA_CFLAGS (CodeRabbit's finding): a
    duplicate -D there wins the CFLAGS redefinition silently while
    print-board-config keeps reporting the board value, so the built power
    mode and the reported one can diverge. The deliberate A/B path is
    `make KBD_DCDC_ENABLE=...`, which the existing parse validation covers
    and print-board-config reports faithfully -- this is also why the
    board assignments stay plain `:=` rather than `override`: the
    command-line override is a designed, tested mechanism, not a hole.
    Flip opencontroller-c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
2026-09-02 firmware: park every unused GPIO as a pulled-up input (power MR1)
    First rung of the power-saving ladder (PowerSavings.md section 10). A
    floating CMOS input can sit mid-rail and burn crossbar current
    continuously; this firmware configured only its UART pins and left every
    other pin in reset state -- including, on the opencontroller profile,
    the unused PA8/PA9 alternate UART pair, and on the MK65MX profile a
    genuinely unconnected PB12 parked as a floating input.
    main() now parks all of PA and PB as pulled-up inputs before any
    peripheral claims its pins (WCH's own low-power examples do the same),
    and KeyboardUart_Init re-claims the UART pins as before. Two deliberate
    exceptions, both for MK65M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
    [keyboard_uart.c, main.c]
2026-09-02 firmware: WFI in RF-IDLE with interrupt-driven UART RX (power MR2)
    Second rung of the power ladder. In RF_STATE_IDLE the core previously
    span at 60 MHz doing nothing; it now executes LowPower_Idle() (WFI,
    flash powered down until next fetch) whenever nothing is pending, and
    three mechanisms make that safe:
    - UART1 RX becomes interrupt-driven: a __HIGH_CODE ISR drains RBR into
    a 64-byte SPSC ring (RECV_RDY clears only by reading data -- an
    ack-only handler would retrigger forever). KeyboardUart_Poll consumes
    the ring; on a stream hole (hardware overrun or full ring) it
    discards the queued ring atomically and resyncs the parser from
    silence, so a retained pre-gap header can never sw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
2026-09-02 review: check the RX-loss latch before every parsed byte
    CodeRabbit/Copilot on #14: the overrun latch was only consumed at the
    top of KeyboardUart_Poll, so a hole recorded by the ISR mid-drain let
    post-gap bytes reach the parser until the NEXT Poll -- one checksum
    coincidence away from dispatching across the gap. The latch is now
    checked before every feed_byte; on a hole the queued ring is discarded
    atomically and the parser resyncs before any further byte is parsed.
    Bytes fed before the latch was set are pre-hole and were valid.
    Also corrects the ld comment ("size" -> "end address", Copilot nit).
    The third comment (TMR3 init idiom risk) is dismissed with evidence:
    the IE/IF register usage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
    [keyboard_uart.c]
2026-09-03 fix: idle via SEVONPEND WFE -- a masked WFI never wakes on this silicon
    The WFI site entered LowPower_Idle() inside a global-IRQ-masked critical
    section, relying on the QingKe manual's "WFI wakes from an interrupt the
    controller can respond to" to mean PFIC-enabled-but-globally-masked
    sources still end the wait. On real silicon they do not: the first WFI
    slept until the ~559 ms WWDG window expired and the chip reboot-looped
    (pwr_wfi_count pinned at 1, ll_boot_count climbing, one reboot per
    watchdog period). The Codex review of the original draft had offered
    exactly this alternative -- "a RAM-resident idle-WFE path with
    WFITOWFE|SEVONPEND" -- and the silicon has now voted for it.
    idle_wait_e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
    [main.c]
2026-09-03 fix: drain the WFE stale-event BEFORE the final wake-source check
    Second Codex adversarial pass (the first reviewed the masked-WFI draft;
    the SEVONPEND-WFE fix that replaced it had never itself been reviewed)
    found a real BLOCKER in the WFE idle path.
    SEVONPEND on this QingKe core only latches a NEW pending edge: a source
    already pending when SEVONPEND is enabled generates no event. The
    single-function idle_wait_event() did its stale-event drain (self-SEV +
    first WFE) AFTER the last wake-source check. So an interrupt that went
    pending in the window between the check and the drain was neither seen
    by the check nor edge-detected by SEVONPEND, and the real (second) WFE
    could sleep past it. The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
    [keyboard_uart.c, keyboard_uart.h, main.c]
2026-09-03 docs: correct the UART1 ISR comment -- RECV_TOUT is not enabled
    Copilot on #14: the ISR comment claimed it drains for RECV_TOUT, but
    KeyboardUart_Init enables only RECV_RDY | LINE_STAT. With the 1-byte
    trigger RECV_RDY fires per byte, so a receive-timeout interrupt would be
    redundant and is intentionally not enabled. Comment now matches the
    configured sources; no behavior change (comment-only).
    [keyboard_uart.c]
2026-09-03 firmware: gate every unused peripheral clock in the sleep domain (power MR3)
    Third rung of the power ladder. One call after HAL_Init marks the clocks
    of every peripheral this firmware never uses -- TMR1/TMR2, UART0/2/3,
    SPI0, PWMX, USB, I2C, LCD -- for gating in R32_SLEEP_CONTROL. Inverted
    API semantics: PWR_PeriphClkCfg(DISABLE, ...) SETS the SLP_CLK bits,
    meaning clock off while the core sleeps.
    The plan expected this rung to be a ~zero-delta prerequisite ("gates in
    sleep only"), but the adversarial review surfaced CH592 datasheet
    section 5.3: the clock-off bits also apply in Idle (SLEEPDEEP=0,
    WFI/WFE). Since the previous rung parks the core in WFE for most of
    each idle second, this rung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
    [main.c]
2026-09-03 review: lock the byte-local assumption behind the RB_SLP_CLK shift
    Copilot on #15: the <<8 silently assumes RB_SLP_CLK_I2C/LCD are
    byte-local masks; a future SDK pin bump redefining them as pre-shifted
    values would gate the wrong clocks without a diagnostic. A preprocessor
    guard turns that into a build error. No binary change.
    [main.c]
2026-09-03 rf: duty-cycle the bonded-reconnect radio search (power MR4)
    Fourth rung of the power ladder, and the first flagged behavior change.
    A bonded keyboard whose dongle is absent searches FOREVER (boot-with-
    bond and A6 30 arm no pair timeout) and until now held the receiver
    open for the whole 20 ms beacon period -- the single largest measured
    burner: 7.75 mA against 0.68 mA idle. The receive window now closes
    KBD_PAIR_RX_WINDOW_TICKS (default 4 TMOS ticks = 2.5 ms, 12.5% duty)
    after the receiver actually arms, bonded flavor only. Beacon cadence,
    channel dwell, and payload are unchanged, so the dongle-visible format
    is identical; only the listen window shrinks. Behavior change:
    reconnect latency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
    [rf_task.c]
2026-09-03 review: track radio-config validity explicitly, not by AA sentinel
    CodeRabbit on #16: any in-band sentinel value for "radio not yet
    configured" collides with SOME legal access address -- the original 0
    sentinel with a zero/corrupt AA (bench-diagnosed), and the complement
    scheme this branch first used with an AA equal to the previous one's
    complement. rf_configure_if_needed now carries an explicit
    rf_configured_valid flag; the bonded entry points clear it instead of
    poking a magic value. Collision class eliminated.
    Verified: both profiles build, 8 host tests pass.
    [rf_task.c]
2026-09-03 firmware: deep-sleep plumbing, runtime-inert (power MR5)
    Fifth rung. A board-validated KBD_DEEP_SLEEP knob (both profiles 1)
    defines HAL_SLEEP=TRUE -- un-stubbing the SDK's TMOS idle-callback
    wiring -- and swaps the SDK's HAL/SLEEP.c for the app-owned
    src/power_sleep.c carrying the same exported symbols. RUNTIME-INERT:
    the pwr_autosleep enable is never set in this rung (the UART
    sleep-protocol rung is its only intended writer), so default builds
    never sleep; an EXTRA_CFLAGS-only bench hook runs ONE SWD-requested
    5 s deep sleep through the full quiesce procedure to answer the
    ladder's two open hardware questions (masked wake, WWDG-in-sleep).
    Why app-owned: the stock CH59x_LowPower would deep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
    [main.c, power_sleep.c, power_sleep.h, rf_task.c, rf_task.h]
2026-09-03 fix: deep sleep via stock plain-WFI, not WFE -- WFE wedges under SLEEPDEEP
    Bench experiments killed the first deep-sleep design. The initial commit
    forked LowPower_Sleep with a SEVONPEND-WFE wait (the mechanism MR2 proved
    for the SHALLOW idle). On hardware it wedged the part -- masked OR
    unmasked, RTC deadline never woke it, RX edge never woke it, only a power
    cycle recovered it. Codex root-cause pass (against the vendor sources and
    the QingKe manual) and the bench agree: WFE-mode (WFITOWFE) is
    incompatible with deep sleep (SLEEPDEEP=1) on this core. The shallow-idle
    lesson does not transfer.
    Fix: use the STOCK SDK LowPower_Sleep (plain __WFI) unchanged, entered
    with global IRQs UNMASKED --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
    [main.c, power_sleep.c, power_sleep.h]
2026-09-03 docs: bench-hook comments describe the UART trigger, not the old SWD poke
    Codex final-verify nit (comment-only): two blocks still described the
    retired SWD-poke bench mechanism. Updated to the UART trigger (A6 54) and
    the on-hardware results. No code change.
2026-09-03 review: clear the RTC trigger flag on disarm; fix diag-capacity comment
    CodeRabbit Major (#17): pwr_rtc_trig_disarm cleared only RB_RTC_TRIG_EN.
    Its premise -- "no RTC_IRQHandler exists, weak stub loops to WWDG reset" --
    is inaccurate: the SDK HAL/RTC.c RTC_IRQHandler is linked and RAM-resident
    (0x2000104e), clears the flag, sets RTCTigFlag. But the fix is sound
    defensively: on a GPIO wake the RTC trigger can fire in the wake-to-disarm
    window, so disarm now also clears the trigger flag (RB_RTC_TRIG_CLR) and
    PFIC pending, making correctness independent of handler linkage. Re-verified
    on bench: RTC deep-sleep wake still works (A6 54 -> 5 s -> wake -> A6 53).
    Copilot nit: the .diag_safe.power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
    [power_sleep.c]
2026-09-03 firmware: UART sleep protocol -- A6 54 explicit deep sleep + NULL wake (power MR6)
    Sixth rung, and the one that routes the deep-sleep floor MR5 proved to a
    real command path. Explicit host-commanded sleep is now LIVE (the TMOS
    autosleep callback stays inert until MR7).
    Protocol (host-facing; OpenDongle/QMK must match):
    - Capability gate: host sends A6 56, module replies 5B 37 92 only if it is
    a deep-sleep-capable build. The generic 61 0D 0A ACK precedes the handler
    and cannot signal capability, so the host must wait for 5B 37. Boot-scoped
    unlock, persists across transport/pair/unpair. A stock host that emits
    legacy A6 54 without the handshake gets a no-op -- it cannot strand a
    mod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
2026-09-03 review: refine sleep-protocol cancel set and explicit-sleep return contract
    Bot review on #18 (both Minor, both real):
    - PowerSleep_ExplicitOnce returned 0 even on an anomalous wake (no GPIO
    edge), contradicting its "3 = did not sleep cleanly" contract, and it
    classified AFTER pwr_gpio_wake_disarm() -- which itself sets pwr_gpio_woke
    from a late pending edge and could mask the anomaly. Now classifies
    before disarm and returns the captured rc (0 clean GPIO wake, 3 otherwise).
    - The reducer cancelled a pending sleep on ANY A6 frame, so an unrecognised
    sub like A6 FF defeated a requested sleep -- contradicting its own
    "unrecognised frames are inert" contract. Cancellation is now r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
2026-09-03 firmware: A6 57 auto-sleep -- autonomous deep sleep in idle and bonded search (power MR7)
    Seventh and final rung: the module may now deep-sleep on its own. A6 57
    (stock: "enable auto-sleep, 2.4 GHz") arms it, behind the MR6 A6 56 gate
    so a legacy host's bare A6 57 stays a no-op. Stock has no disable opcode,
    so re-sending A6 56 -- "reset sleep protocol to baseline" -- is the
    disable path (owner-confirmed). Lifetime: explicit fresh pairing (A6
    51/63) and unpair (A6 52) clear it (user-attended, latency-sensitive);
    transport selects (A6 11/30/31-33), queries, unknown subs, A1/A9 and the
    host ACK preserve it; boot clears it. The pure reducer owns the flag and
    main.c mirrors it into the power modu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
    [keyboard_uart.c, keyboard_uart.h, main.c, power_sleep.c, power_sleep.h, sleep_protocol.c, sleep_protocol.h]
2026-09-04 firmware: route every deep sleep through the TMOS idle callback; UART diag dump
    A latent bug in the shipped explicit sleep (PR #18) and MR7 auto-sleep
    (PR #19): LowPower_Sleep was called from the main loop, behind the TMOS
    BLE library's back. The library re-initialises its baseband/LLE only when
    its idle callback returns 0, so a sleep it never saw left the NEXT RF
    operation (an A6 30 bonded-search entry after a wake) hung inside
    TMOS_SystemProcess until the ~559 ms watchdog reset the part. It
    masqueraded as a deterministic "2.65 s reconnect" for two days.
    Found with a new bench tool (Part A); fixed by routing every sleep
    through the callback (Part B).
    Part A -- UART diag dump (bench only;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
    [diag_dump.c, diag_dump.h, diag_frame.c, diag_frame.h, keyboard_uart.c, keyboard_uart.h, main.c, power_sleep.c]
2026-09-04 review: guard diag-zero while connected; thaw only on a complete dump; fix forensics link
    PR #20 bot review (1 Major, 4 Minor, all real):
    - CodeRabbit Major: DiagDump_Zero (A6 72) cleared the counters and the
    retained fault-forensic record with no state check, while DiagDump_Send
    refuses over a live link -- a connected host could wipe diagnostics.
    Now returns early when CONNECTED.
    - Copilot + CodeRabbit: DiagDump_Send thawed pwr_forensics_frozen even
    when the dump was REFUSED (empty 5D 00 5D while CONNECTED) or TRUNCATED
    (KeyboardUart_SendRaw returns < n when the host is not draining),
    losing the pre-crash record unread. Now thaws only after a complete,
    non-empty frame actually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
    [diag_dump.c, power_sleep.c]
2026-09-04 rf: widen the bonded-reconnect RX window to 6 ticks (3.75 ms) -- 4 ticks closed as the OpenDongle camp reply was completing
    With power MR4 (PR #16) the bonded-reconnect search listens only for
    KBD_PAIR_RX_WINDOW_TICKS = 4 x 625 us = 2.5 ms after each beacon's receiver
    arm. The OpenDongle CH570 sends its LEN-15 reconnect reply 2.5 ms after the
    beacon it heard (RF_CH570_PAIR_ACK_PRE_TX_TMOS = 4, its Bridge75 optimum),
    ~214 us on air, measured 2538..2551 us from accept to StartTx with the
    dongle's new diagnostics page. This receiver arms ~0.2 ms after the beacon,
    so the window closed at beacon + ~2.7 ms, exactly as that reply was
    completing. From the dongle's terminal camps -- its first reconne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
2026-09-04 review: state the window bound as measured (4 fails) vs unproven (<6), not a hard >=5
    Copilot on #21: the "values below 5 miss it" / ">= 5 required" wording
    implied a proven 5-tick threshold, but the bench only measured 4 ticks
    failing (0/8 cold) and 6 working (6/6); 3 and 5 were never tried. Reworded
    the code comment and README row to separate proven-bad (<= 4) from unproven
    (< 6, re-measure before lowering), and fixed "4 fail" -> "fails".
    CodeRabbit on #21 (S2/S3 re-meter before merge): tracked -- the re-meter
    is in progress on the bench; the PR body already lists it as owed and the
    duty-cycle figure in the comment is arithmetic (12.5% -> 18.75%), not a
    measured power claim. Comment/doc o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
    [rf_task.c]
2026-09-11 docs: compare production and OpenController power management
    Traces the production keyboard image's power management and sets it beside
    OpenController's, to establish where the remaining savings actually are.
    The headline: OpenController already implements substantially the same retained
    deep-sleep mechanism as production. The difference that matters is not a lower-
    level sleep instruction or a smaller retention mask, but WHEN the radio is
    allowed to stop. Production has an automatic inactivity ladder -- roughly five
    seconds to a first stage that drops the session and probes about once a second,
    and thirty minutes to a second stage that stops probing entirely. OpenController
    deliberately ke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
2026-09-11 power: rest the 2.4 GHz link when the keyboard is idle
    OpenDongle's Tier 2 savings only engage against a keyboard that rests: its
    windowed receiver and halt path key off a scheduled-drop cadence, and a
    keyboard that holds its link keeps the dongle in continuous receive. Production
    rests; OpenController did not, so for our own keyboard the dongle sat at its
    Tier 1 numbers. This adds the resting policy.
    After KBD_REST_IDLE_TICKS (5 s, production parity) without a host report on a
    connected link, the session is dropped SILENTLY -- no frame to the dongle,
    which lapses by its own supervision into its bonded camp, and nothing to the
    keyboard MCU, which keeps seeing a connected link. Thereafter th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
2026-09-11 review: count probe answers on TX completion, and four smaller fixes
    From the CodeRabbit and Copilot reviews on #23.
    The one that matters: a probe answer was counted when RF_Tx() returned 0, which
    only means the transmission STARTED -- a started TX can still reach
    TX_MODE_TX_FAIL. The probe could therefore end having delivered nothing, which
    is precisely the condition that makes the dongle classify the drop as
    unscheduled (rf_win_link_rx == 0) and unlock its scheduled-drop detector, the
    failure mode this whole policy depends on avoiding. Counting moves to the
    TX_MODE_TX_FINISH branch, guarded by response_pending (a pairing beacon raises
    TX_FINISH too) before that flag is cleared.
    Also:
    -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
    [main.c, rf_task.c, rf_task.h]
2026-09-11 review: separate the two kinds of verification in the closing note
    From the CodeRabbit review on #22. The closing note said "no firmware build or
    hardware verification is claimed", which reads as disclaiming the bench run this
    same document reports -- a flashed production HalSleepFalse image with observed
    UART and RF behaviour, recorded in the assessment and the bench addendum.
    Those are two different things. No OpenController source change was built or
    verified on hardware; the bench observations ARE claimed evidence, of the
    production behaviour the report reconstructs. The note now says so.
    Claude-Session: https://claude.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
2026-09-12 docs: close D4 -- the MCU driver holds its link view across rest
    The resting policy shipped with one open caveat: rest is designed to be
    transparent to the keyboard MCU, but QMK's sync_target() calls reconnect_2g4()
    whenever selected_target reads UNKNOWN, and nobody had checked what the real
    MCU driver does while the controller is silent. The bench stand-in HAD disrupted
    rest, which left the question genuinely open.
    Verified by compiling the shipping MonacoKeys QMK driver (opencontroller.c and
    opencontroller_protocol.c) for the host and running it in the loop against the
    live controller over the probe UART, so the code under test is the real driver
    rather than a stand-in. The only source ed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
2026-09-12 review: measure stage 2 under control, and stop leaning on the 8.5 h run
    CodeRabbit flagged that the 8.5-hour paragraph claimed the link view survives
    stage 2 and then, two sentences later, said stage 2 had never been validated
    under controlled conditions. That is self-contradictory, and an uncontrolled run
    is the wrong thing to hang a specific claim on. Fixed by measuring it properly
    rather than by softening the wording.
    Controlled stage-2 run: 2100 s of rest under caffeinate, so the window clears
    the 30 min threshold with margin and the harness is never frozen. Driver sent 0
    bytes, controller sent 0 bytes, link_state and selected_target never moved,
    connection_generation stayed at 1, tx_a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
2026-09-12 review: scope the zero-byte claims to the UART during the rest window
    CodeRabbit, minor but fair: "the driver sends nothing" reads as "nothing
    happens", when in stage 1 the controller is still probing on air once a second
    and the key wakes carry their own A1 and ACK traffic. The measurement was always
    UART bytes between controller and MCU across the rest window, with wake traffic
    counted separately. Say so rather than let the stronger reading stand.
    Claude-Session: https://claude.ai/code/session_01T6NgzJurowbWP2HXgtiVBA
2026-09-12 bench: per-report keystroke oracle (report-delivery step 1)
    The report-delivery fix needs a delivery/order oracle the plan can gate on. The
    macOS HID idle timer used earlier only shows that some input arrived; Codex's
    review of the first-key measurements was right that it cannot identify the key,
    tell a press from a release, or prove order, so it cannot verify "every press
    and release reached the host in order".
    hid_capture.py installs a listen-only CGEventTap and logs every keyDown/keyUp/
    modifier change for a chosen key set as NDJSON with monotonic-ms timestamps.
    Attribution is by key choice, as the SWD/host injector already does: inject a
    key the human is not pressing (F13/F24 or a bare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
2026-09-12 controller: report rx/tx counters (report-delivery step 1 observability)
    Two plain-.bss counters read by symbol over SWD (post-run only; SWD resets the
    controller and drops the link): ll_hid_rx counts host reports handed to the RF
    layer via RF_QueueHIDReport (over UART), ll_hid_tx counts LEN-10 HID frames put
    on air. With the MCU's offered count and the host oracle, a key that the MCU
    offered and the controller transmitted (ll_hid_tx advanced) but the host never
    saw localises the loss downstream of the controller -- the dongle hop.
    No functional change (RF_DIAG_INC, on by default). Builds clean.
    Claude-Session: https://claude.ai/code/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
    [rf_task.c]
2026-09-12 diag: carry the report-delivery counters in the UART dump (frame v3)
    The report-delivery counters could only be read over SWD, and an SWD read near
    an RF operation halts the CH592 mid-op and faults it to a WWDG reset -- so any
    per-trial read corrupted the very measurement it was taking.
    Carry them in the existing A6 71 UART dump instead, which the bench reads
    through the host MCU's trace ring without touching the module: payload v2 -> v3,
    65 -> 85 bytes, five u32s appended (ll_hid_rx/tx, the key-down split, and the
    on-air completion count). All pre-existing field offsets are unchanged; a strict
    v2 reader must be updated for the length and version byte. A6 72 zeroes the new
    counters too, so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
    [diag_dump.c, diag_frame.c, diag_frame.h]
2026-09-12 rf: retire HID reports on the dongle's ack, not a blind attempt counter
    The first key after the link rests was lost ~38% of the time (bench: 15/24
    delivered). Cause: the module held exactly one 8-byte `hid_report` and retired it
    with a blind 6-attempt counter. A tap that lands while the link is resting is
    transmitted into a link that is not up yet -- those frames go nowhere -- and 60 ms
    later the key-up overwrites the same slot, so when the link finally comes up only
    the release is sent. Per-trial the lost taps put ZERO down-frames into the dongle
    while delivered taps put 2-6; in aggregate the module put 108 down-frames on air
    and the dongle received 40.
    Replace the slot with a 16-entry rin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
    [rf_task.c]
2026-09-12 bench: keep the CGEvent tap alive across sleep, and record the first-key run
    macOS disables a listen-only event tap across system sleep, so the oracle went
    deaf exactly when a suspend test needed it; re-arm on the disable event.
    Record the measurement that drove the fix, including the two traps that made
    earlier results meaningless: the bench driver's default host is AUTO, which
    resolves to the host MCU's OWN USB whenever that is plugged in, so the taps never
    traversed the module at all; and a module reboot during rest zeroes the .bss
    counters mid-run.
    Claude-Session: https://claude.ai/code/session_01T6NgzJurowbWP2HXgtiVBA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
2026-09-13 review: address CodeRabbit and Copilot feedback
    - carry ll_hid_fifo_drop in the UART dump. A6 72 already zeroed it, so leaving it
    out of the payload implied it was observable when it was not (payload 85 -> 89).
    - enforce the power-of-two invariant HID_FIFO_SLOTS relies on: the head/tail
    indices are free-running and masked, so a future 20-slot ring (as stock uses)
    would silently corrupt indexing.
    - stop describing ll_hid_tx as "put on air". It is incremented before RF_Tx(), so
    a transmission that fails to start still counts; reading it as delivery is what
    made an earlier analysis localise the loss downstream of the controller. The
    stale "6x resend" reference went with the blind at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
    [diag_dump.c, diag_frame.c, diag_frame.h, rf_task.c]
2026-09-13 docs: record the gate 4 result -- it failed, and this PR fixes it
    Gate 4 ("first key from rest, no lost key") had never been run. It fails: ~38 %
    of first keys from rest never reached the host (15/24). The module held one
    8-byte hid_report retired by a blind attempt counter, so a tap landing while the
    link rested was transmitted into a link that was not up yet and its key-up then
    overwrote the slot -- only the release was sent. The ack-retired queue in this PR
    takes it to 24/24; a smaller EP1-slot loss that surfaced afterwards is fixed by
    OpenDongle #51.
    Also records the two measurement traps that invalidated an earlier attempt at
    this gate, because either one silently produces a passing re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
2026-09-13 rest: T_idle 3 s by default, KBD_REST_IDLE_MS build knob; fix the bond guard on macOS
    Owner decision 2026-09-13 after the hold sweep on the controller rail
    (firmware/bench/2026-09-13-rest-hold-sweep): 2 / 3 / 5 s cost 16.8 / 23.8 /
    39.0 mC per key from rest (~7.4 mA x T_idle + 2 mC), 108/108 first keys
    delivered at every hold with reconnect latency 30-90 ms regardless, and a
    dongle outage recovers through rest instead of supervision. 3 s takes 40 %
    off every rest-wake with no measured downside on a clean link; production
    parity stays one knob away.
    KBD_REST_IDLE_MS (default 3000, validated 500..60000, reported by
    print-board-config) is converted to TMOS 625 us ticks in one place; the
    tick m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
    [diag_frame.h, rf_task.c]
2026-09-13 review: take the bench scripts' paths and probe serials from the environment
    Copilot on #27: the archived scripts hardcoded this machine's QMK checkout,
    tools and toolchains. Every path, the probe serials and the LED floor are now
    env-overridable (defaults unchanged, so the archived runs still reproduce
    here); the README lists the variables.
    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
2026-09-13 review: bench scripts fail closed and the flash helper uses the ms knob
    CodeRabbit on #27: drought2.py now raises when a rail command fails (as
    drought.py already did); hold_sweep2.py refuses to record an episode that
    did not start from certified rest and keeps the last key inside the active
    workload window; flash_hold.sh passes KBD_REST_IDLE_MS (the tick macro is
    rejected by the Makefile now), runs with pipefail and stops on a failed
    build or flash instead of recording a stale image hash; the README states
    the observed latency maxima next to the typical range.
    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
2026-09-13 review: charge summary tolerates skipped episodes
    CodeRabbit on #27: with the settled gate now skipping episodes, the summary
    must not divide by zero and must report the recorded count, not the
    requested one.
    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
2026-09-13 rest: never rest while a key is held; re-assert survives a teardown
    The rest policy counted only host reports as activity, and a held key
    produces none: after T_idle the link rested, the dongle released every key
    on the host (keys-up on the lapse) and the user was still holding it.
    Bench 2026-09-13 (CGEventTap oracle): a 7 s hold on the 5 s image lost its
    auto-repeat at 5.02 s and got a keyUp at 5.03 s. A shorter T_idle makes it
    bite sooner (3 s: a long arrow-key scroll).
    The REST_IDLE gate now also requires the newest queued report to hold no key
    or modifier (hid_key_held), re-checking every KBD_REST_IDLE_RETRY_TICKS; the
    release restarts the full T_idle through rest_arm_idle as before.
    T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
    [rf_task.c]
2026-09-13 review: set hid_last_queued_valid on the FIFO-full coalesce path too
    Copilot on #28: the coalesce path updated hid_last_queued without setting
    its valid flag. That was harmless while the flag only ever went 0 -> 1, but
    this branch clears it on the supervision teardown, so a report arriving
    while the ring is full would leave it false for good. Two consequences, not
    one: the adjacent-duplicate dedup stops (every report counts as a
    transition), and hid_key_held() reads the same flag, so the rest gate would
    let the link rest under a held key -- exactly the defect this branch fixes.
    Also documents OPENCONTROLLER_REPO and BENCH_DIR in the bench helper's
    environment block, which the earlier path-p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
    [rf_task.c]
2026-09-13 review: invalidate the dedup cache in RF_Disconnect() too
    CodeRabbit on #28: the supervision teardown was not the only path that drops
    the link. RF_Disconnect() is the funnel for SELECT_USB, SELECT_BT2/BT3,
    unpair, factory pair, the firmware-update quiesce and explicit sleep; each
    leaves the dongle to lapse and release every key on the host, while the
    newest queued state still claimed those keys. A caller that sends a release
    barrier first (the driver's forced reconnect, and its explicit sleep, which
    refuses while a key is held) was safe; the others would have let the
    adjacent-duplicate check swallow a re-press of the same key.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
2026-10-04 firmware: add update-qmk, updating the module through the keyboard
    QMK-hosted updates were thought to need an OBP client on the keyboard's
    MCU. They do not: the protocol is transport-agnostic, the client stays on
    the PC, and QMK only has to forward bytes. The module is unaware it is
    being tunnelled and still reports its transport as UART.
    update-qmk builds and bundles exactly as update does, and keeps the ODG2
    family-0xB2 guard - OpenBoot's COMMIT attests only length and CRC, so that
    host-side check remains the only thing standing between a bench and a
    cross-flashed dongle image. What it drops is the pyserial A6 81 27 poke and
    the fixed 6 s sleep: the transport owns both now, anchoring on t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
2026-10-04 firmware: record the MK65MX B02 DC-DC measurements
    288decb shipped without a hardware run. It has now been flashed to the
    CH592F on an MK65MX Wireless rev B02 keyboard through the QMK OpenBoot
    tunnel and measured against the LDO build it replaces, so the README's
    KBD_DCDC_ENABLE section records the results.
    Whole-board current at the USB input, LED matrix in the same state:
    26.7 -> 24.3 mA with the keyboard routed to USB, 31.2 -> 26.8 mA routed
    to 2.4 GHz. The radio's share fell from 4.5 to 2.5 mA, matching the
    datasheet's 7.5 vs 3.5 mA receive current. Received signal strength at an
    OpenDongle in DC-DC, LDO and DC-DC runs with nothing moved had medians of
    -71, -68 and -69 dBm: about 2 dB w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
2026-10-04 firmware: bump OpenBoot to d89d4d6
    d89d4d6 is OpenBoot main. It carries the qmk transport that update-qmk
    needs (38dae42 and its review fixes), and for the bootloader an open flash
    driver in place of libISP, built with LTO, plus an opt-in page erase that
    nothing here enables.
    What an update puts on a module is unchanged. The slot geometry (A at
    0x2000, B at 0x39000, 0x37000 slots, 0x36000 capacity, 32-byte record) is
    identical, the record still sits at slot end - 4 KiB, openboot_app.c changes
    only in comments and a stricter compile-time check, and slot A builds
    byte-identical for both opencontroller-ch592 and mk65mx-wireless-ch592.
    Modules in the field keep their bootloader and see no diffe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
2026-10-04 docs: drop the firmware README's references to the removed BOOT.md
    BOOT.md went in 6788284 but the README still sent readers to it three
    times. Drop the pointer from the reset-recovery note, say where the 216 KiB
    slot capacity comes from, and point the boot-chain section at the
    bootloader documentation in the OpenBoot submodule, keeping the A6 81 entry
    path that BOOT.md used to describe.
2026-10-04 firmware: drop comment references to the removed BOOT.md and TMOS_REVIEW.md
    6788284 removed firmware/BOOT.md and firmware/docs/TMOS_REVIEW.md, but
    the Makefile, the linker script and rf_task.c still pointed at them. Point
    the update-flow and soak references at the firmware README, which now
    covers them, point the boot-request mailbox at OpenBoot's app README, and
    drop the TMOS_REVIEW.md pointers: each comment already states the finding
    it cited.
    Comments only. Both boards' factory images build byte-identical.
    The bench record under bench/2026-09-12-first-key keeps its BOOT.md quote,
    since it records what the docs said at the time.
2026-10-04 review: probe the qmk transport through the CLI's parser; move the UART comment
    The update-qmk guard grepped the CLI's help for '--transport qmk', which
    only matched because one option's description happens to say
    "(--transport qmk only)". Ask the parser instead: `--transport qmk
    --help` succeeds on a CLI that knows the transport and fails with
    "invalid value 'qmk'" on one that does not. Checked against both kinds of
    CLI: the old one still stops with the bump message, the new one passes the
    guard and reaches the tunnel lookup.
    Splitting out check-bundle-family left the UART update description above
    the family check, which never opens a port, and the update rule without a
    header. Keep only t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
2026-10-08 firmware: raise CHWAKE before every frame for hosts that sleep
    A keyboard MCU that sleeps, such as the MK65MX B02's STM32U073 in STOP 2,
    can't receive UART frames. With KBD_HOST_WAKE=1 the module raises CHWAKE
    (PB13, wired to the STM32's PA1) before every status, host-LED or battery
    frame it sends, waits a 1 ms guard for the host to wake, holds the line
    until the host ACKs, and sends each frame up to three times.
    - src/host_wake.c holds the outstanding frames with ACK accounting, a
    latest-value slot for LED and battery state, and a non-blocking
    guard. An LED state abandoned unacknowledged is offered again
    (RF_LedResync()).
    - The host asks with A6 58 and the module answers 5B 38, so a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
2026-10-09 firmware: drop reports queued for 2.4 GHz when the host leaves it
    RF_Disconnect() keeps the HID FIFO, so reports typed while the link was
    down survived a switch to USB and typed themselves out the next time
    2.4 GHz connected, long after the host had moved on. QMK, though, also
    sends SELECT_USB then SELECT_2G4 back to back to force a fresh CONNECTED
    (reconnect_2g4), and that reconnect must keep them.
    SELECT_USB and the BT selects now arm a one-shot TMOS event,
    RF_EVT_DISCARD_HID, KBD_RESELECT_KEEP_TICKS (500 ms) out; RF_Select2G4()
    cancels it. When it fires it drops the FIFO, only in IDLE, where the
    radio is shut and the RX ISR that retires the head can't run. A timer
    rather than a timestamp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
2026-10-09 firmware: answer an ignored A6 51 with the live link
    RF_EnterPairing() ignores A6 51 while CONNECTED, on purpose: a stray or
    late PAIR must not tear down a healthy link. main.c still answered
    5B 31 / 5B 23, so the host took the live link for PAIRING and stopped
    sending reports on it. QMK's pairing session can do exactly that: its
    re-arm {SELECT_2G4, PAIR} can land just after the pairing connected, and
    it carries a workaround (re-select 2.4 GHz to get RECONNECTING back).
    RF_EnterPairing() now returns whether it entered pairing, and an ignored
    request is answered 5B 32. A host that tracks connections by 5B 32 (QMK
    counts a connection generation) sees a link it already has, never a
    false pairi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
    [main.c, rf_task.c, rf_task.h]
2026-10-09 firmware: leave the host's LEDs to the dongle's relay on connect
    rf_enter_connected() sent 5A 00 with its 5B 32 / 5B 23, before the
    dongle's LED relay could arrive. Caps Lock read off after every full
    reconnect until the relay came, and for good behind a dongle that never
    re-sent it on a reconnect (OpenDongle's EV10 path, fixed in
    openkeyboard-org/OpenDongle#54). It now sets last_led_sent to 0xFF, so the
    relay is forwarded whatever its value and the host's LEDs are left alone
    until it comes. The trade-off: behind a dongle that doesn't relay on a
    reconnect, the host keeps the state it last had, which is wrong only if
    the LEDs changed while the link was down; 5A 00 was wrong whenever any
    LED w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
    [rf_task.c]
2026-10-25 hardware: add the CH572 castellated wireless module
    A 10.0 x 20.5 mm two-layer module built around the WCH CH572D, meant to
    be soldered onto a keyboard PCB beside the host MCU. It reuses
    OpenDongle's independently created, WCH-informed PCB antenna (footprint
    copied unchanged) and 0.8 mm stackup, on the same 10.0 mm board width so
    the antenna sees the same ground edge. Ground pours stop at the
    antenna's lower edge with a 0.5/0.2 mm via fence, as on OpenDongle.
    The CH572D runs in single 3.3 V supply mode (V5 and VIO33 tied to
    VDD33) from a Torex XC6206P332MR-G LDO (C5446, JLC Basic), with a
    2.2 uF + 100 nF pair at VDD33 and a 32 MHz 8 pF crystal on the internal
    load capacitance.
    The host int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
2026-10-25 hardware: commit the CH572 schematic PDF and gerber/NC drill set
    Exported with kicad-cli 10.0.6 using the commands in
    hardware/CH572/README.md, from the design in the previous commit. The
    job file records 2 layers, the OpenDongle stackup and castellated pads;
    the drill file tags the castellated holes.
2026-10-25 hardware: move the CH572 castellations to a 0.1 in grid
    Nine castellated half-holes (1.0 mm drill, 1.5 x 3.0 mm pads) replace the
    eight on a 2.4 mm pitch: three on each side and three on the end opposite
    the antenna, all on one 0.1 in grid so a host can also take standard pin
    headers. The board widens from 10.0 mm to 10.16 mm so the side rows sit
    0.4 in apart; the antenna stays centred. Viewed from the top with the
    antenna at the bottom, the pads count counter-clockwise from the
    top-left: 1 GND, 2 UART_TX, 3 UART_RX, 4 NRST, 5 VCC, 6 GND, 7 SWDIO,
    8 SWCLK, 9 WAKE.
    The board is now drawn with the antenna at the bottom (rotated 180
    degrees). Besides the new J1 footprint and the wider outline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
2026-10-25 hardware: regenerate the CH572 fab outputs for the 0.1 in castellations
    job file records the 10.16 mm board, 2 layers, the OpenDongle stackup
    and castellated pads.
    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
2026-10-25 hardware: add the CH592 castellated wireless module
    A pin-compatible CH592D version of the CH572 module: the same 10.16 x
    20.5 mm outline, OpenDongle antenna, 0.8 mm stackup, JLCPCB board rules
    and 9-pad 0.1 in castellated edge. Pad 4 (NRST) is not connected,
    because the CH592D's QFN-20 has no reset pin. The UART uses PB13/PB12,
    the UART1 remap of the opencontroller-ch592 firmware profile and
    OpenBoot board; SWD is PB14/PB15 and WAKE is PA11.
    The CH592D runs from the XC6206P332MR-G LDO (C5446) with its internal
    DC-DC fitted, as the firmware enables it: L1 10 uH, C4 4.7 uF on VDCID,
    VDCIA tied to VDCID, C5 470 nF on VINTA and C2 2.2 uF on VDD33, the
    datasheet's recommended values. U1 follows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
2026-10-25 hardware: commit the CH592 schematic PDF and gerber/NC drill set
    hardware/CH592/README.md, from the design in the previous commit. The
    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
2026-10-25 hardware: keep the CH572 exposed-pad paste off its thermal vias
    The exposed pad's four 0.2 mm GND vias sat inside the footprint's 2 x 2
    paste windows, so solder could wick into the open barrels during reflow
    and starve the CH572D's only ground connection (CodeRabbit review).
    U1 now uses a project copy of KiCad's QFN-20-1EP_3x3mm_P0.4mm_EP1.65x1.65mm
    land pattern with four 0.4/0.2 mm thermal vias built in, 0.6 mm from the
    centre along each axis. The paste is a central window plus four edge
    windows covering about 47% of the pad, each at least 0.1 mm clear of the
    via copper. The separate board vias in the pad are gone. ERC and DRC
    (with schematic parity) report no violations.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
2026-10-25 hardware: regenerate the CH572 fab outputs for the thermal-via footprint
    hardware/CH572/README.md. The paste layer now keeps the exposed-pad
    windows off the four thermal vias.
    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
2026-10-25 hardware: keep the CH592 exposed-pad paste off its thermal vias
    The same fix as for the CH572: the exposed pad's four GND vias sat inside
    the paste windows, so solder could wick into the open barrels during
    reflow (CodeRabbit review on #34).
    U1's CH592D footprint now has four 0.4/0.2 mm thermal vias built in,
    0.7 mm from the centre along each axis, and its paste is a central
    window plus four edge windows covering about 53% of the 1.9 mm pad, each
    at least 0.075 mm clear of the via copper. The separate board vias in
    the pad are gone, and the bottom-layer SWDIO run now crosses under U1
    between the two rows of thermal vias. ERC and DRC (with schematic
    parity) report no violations.
    Co-Authored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
2026-10-25 hardware: regenerate the CH592 fab outputs for the thermal-via footprint
    hardware/CH592/README.md. The paste layer now keeps the exposed-pad
    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
2026-10-25 hardware: draw the CH572D QFN footprint for OpenController
    U1's thermal-via footprint was a modified copy of KiCad's
    QFN-20-1EP_3x3mm_P0.4mm_EP1.65x1.65mm. KiCad's libraries are CC-BY-SA
    4.0, and their exception does not cover library parts redistributed as
    separate files, so that copy could not sit in a CERN-OHL-W project
    library (Codex review).
    The new footprint is drawn from scratch from the CH572 datasheet's QFN20
    drawing (3.0 +/- 0.1 mm body, 1.8 +/- 0.2 mm exposed pad, 0.35 +/- 0.12
    mm leads):
    - lands 1.15 to 1.85 mm from the centre, 0.15 mm clear of the largest
    exposed pad;
    - a 1.8 mm exposed-pad land with four 0.4/0.2 mm tented thermal vias at
    (+/-0.65, +/-0.65) mm;
    - exposed-pa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
2026-10-25 hardware: regenerate the CH572 fab outputs for the new QFN footprint
    hardware/CH572/README.md.
    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
2026-10-25 hardware: draw the CH592D QFN footprint for OpenController
    U1's footprint started from a copy of KiCad's QFN-20 footprint, which
    KiCad's CC-BY-SA 4.0 library licence does not let a CERN-OHL-W project
    library carry as a separate file (Codex review). It is now drawn from
    scratch from the CH592 datasheet's QFN20 drawing, with the same
    geometry as before:
    - lands 1.20 to 1.85 mm from the centre;
    - a 1.9 mm exposed-pad land with four 0.4/0.2 mm tented thermal vias at
    (+/-0.7, +/-0.7) mm;
    - the same paste windows.
    hardware/NOTICE records its provenance alongside the CH572D footprint.
    README corrections from the same review: paste coverage is 51% once the
    windows' rounded corners are counted (no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
2026-10-25 hardware: regenerate the CH592 fab outputs for the new QFN footprint
    hardware/CH592/README.md.
    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
2026-10-25 hardware: describe the CH572 thermal vias as open on the component side
    The CH572D footprint called its thermal vias tented, and so did
    4571158. They sit inside the exposed pad's solder-mask opening, so they
    are open on the component side and tented only on the bottom (Codex
    review). The footprint description and README now say so, and note the
    trade-off: TI's thermal-pad guidance prefers component-side caps, but
    open vias in the exposed pad have worked in OpenKeyboard testing.
    The footprint geometry and the fab outputs are unchanged; U1 on the
    board is re-synced to the library footprint. DRC (with schematic parity)
    reports no violations.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
2026-10-25 hardware: describe the CH592 thermal vias as open on the component side
    As for the CH572: the CH592D footprint and 6227d4b called its thermal
    vias tented, but they sit inside the exposed pad's solder-mask opening,
    so they are open on the component side and tented only on the bottom
    (Codex review). The footprint description and README now say so, with
    the same trade-off note.
    reports no violations.
    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
2026-10-25 hardware: state where pad numbering starts and separate VCC from the 3.3 V signals
    CodeRabbit pointed out that "numbered counter-clockwise from the top-left"
    reads as if pad 9, the leftmost pad on the top edge, were pad 1. Name pad 1
    as the uppermost pad on the left edge and spell out the path around the
    three edges, both under the shared pinout diagram and in the CH572 README.
    The CH572 README also said that all I/O is 3.3 V, while its pinout table gives
    VCC as a 3.3 V to 6.0 V input. Limit the 3.3 V, not-5-V-tolerant statement to
    the J1 signals and give the VCC range beside it.
2026-10-25 hardware: give the CH572 thermal vias a 0.20 mm annular ring
    U1's four thermal vias are pads in the footprint, so the drill file lists
    them as plated component holes rather than vias. At 0.4 mm on a 0.2 mm
    drill their ring was 0.1 mm, under JLCPCB's 0.20 mm for plated pad holes
    (0.18 mm absolute minimum on 2-layer 1 oz), and a 0.2 mm hole with less than
    0.45 mm of copper is also priced as a fine via. CodeRabbit flagged the ring.
    Make the four pads 0.6 mm in the library footprint and in the placed U1.
    Drills, positions, the exposed-pad land and its paste windows are unchanged.
    The paste stays at least 0.19 mm from the via holes; it now overlaps the outer
    0.01 mm of the rings, which on the to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
2026-10-25 hardware: regenerate the CH572 fab outputs for the 0.6 mm thermal-via pads
    Only U1's four thermal-via pad flashes change, from 0.4 to 0.6 mm, on F.Cu
    and B.Cu; the remaining differences are timestamps and aperture numbering.
2026-10-25 hardware: apply #34's pad-numbering and VCC wording to the CH592 README
    Name pad 1 as the uppermost pad on the left edge and spell out the path
    around the three edges, and limit the 3.3 V statement to the J1 signals,
    with VCC's 3.3 V to 6.0 V range beside it, as in the CH572 README.
2026-10-25 hardware: give the CH592 thermal vias a 0.20 mm annular ring
    0.45 mm of copper is also priced as a fine via. CodeRabbit flagged the ring
    on the CH572 module in #34; this footprint had the same pads.
    The paste stays at least 0.175 mm from the via holes; i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
2026-10-25 hardware: regenerate the CH592 fab outputs for the 0.6 mm thermal-via pads
    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
2026-10-25 hardware: update the placed CH572 U1's description for the 0.6 mm vias
    450495d widened the thermal-via pads in the library footprint and the placed
    U1, but the board's copy of the footprint description still said 0.4/0.2 mm.
    Copy the library description onto U1. Nothing else changes, so the fab
    outputs stay as they are.
    For the record, 8ed7230's message understates its diff: besides timestamps
    and aperture numbering, KiCad also reordered some unchanged plot commands.
    Its only geometric change is still the eight via-pad flashes.
2026-10-25 hardware: update the placed CH592 U1's description for the 0.6 mm vias
    94886b9 widened the thermal-via pads in the library footprint and the placed
    For the record, 49217e0's message understates its diff: besides timestamps
    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
2026-10-25 firmware: add SPDX headers to the tests, bench scripts and board profiles
    The firmware sources already carry a copyright line and an SPDX licence
    identifier. Eleven tracked files did not: the five pytest modules, the four
    2026-09-13 bench scripts and the two board profile makefiles. Give them the
    same two-line Apache-2.0 header as firmware/Makefile, after the shebang where
    there is one.
    No code changes. The edited Python files compile and the zsh script passes a
    syntax check.
